jan-tec/tensile-tester/test/README

This directory is intended for PlatformIO Test Runner and project tests.

Unit Testing is a software testing method by which individual units of
source code, sets of one or more MCU program modules together with associated
control data, usage procedures, and operating procedures, are tested to
determine whether they are fit for use. Unit testing finds problems early
in the development cycle.

More information about PlatformIO Unit Testing:
- https://docs.platformio.org/en/latest/advanced/unit-testing/index.html

## House Unity notes

- Unity (as bundled with PlatformIO) has **no `TEST_ASSERT_NOT_EQUAL_STRING`**
  - use `TEST_ASSERT_TRUE(strcmp(a, b) != 0)` instead (found 2026-10-11, M6-T004).
- Exact-string pins are the house style for wire formats and message
  tables (`TEST_ASSERT_EQUAL_STRING`) - see `test_api_response.cpp` for
  the JSON envelope pins.
