jan-tec/tensile-tester/hardware/mainboard-atlas/Mainboard-ATLAS.kicad_pcb

## KiCad design hardware/mainboard-atlas/Mainboard-ATLAS.kicad_pcb (2026-10-11)

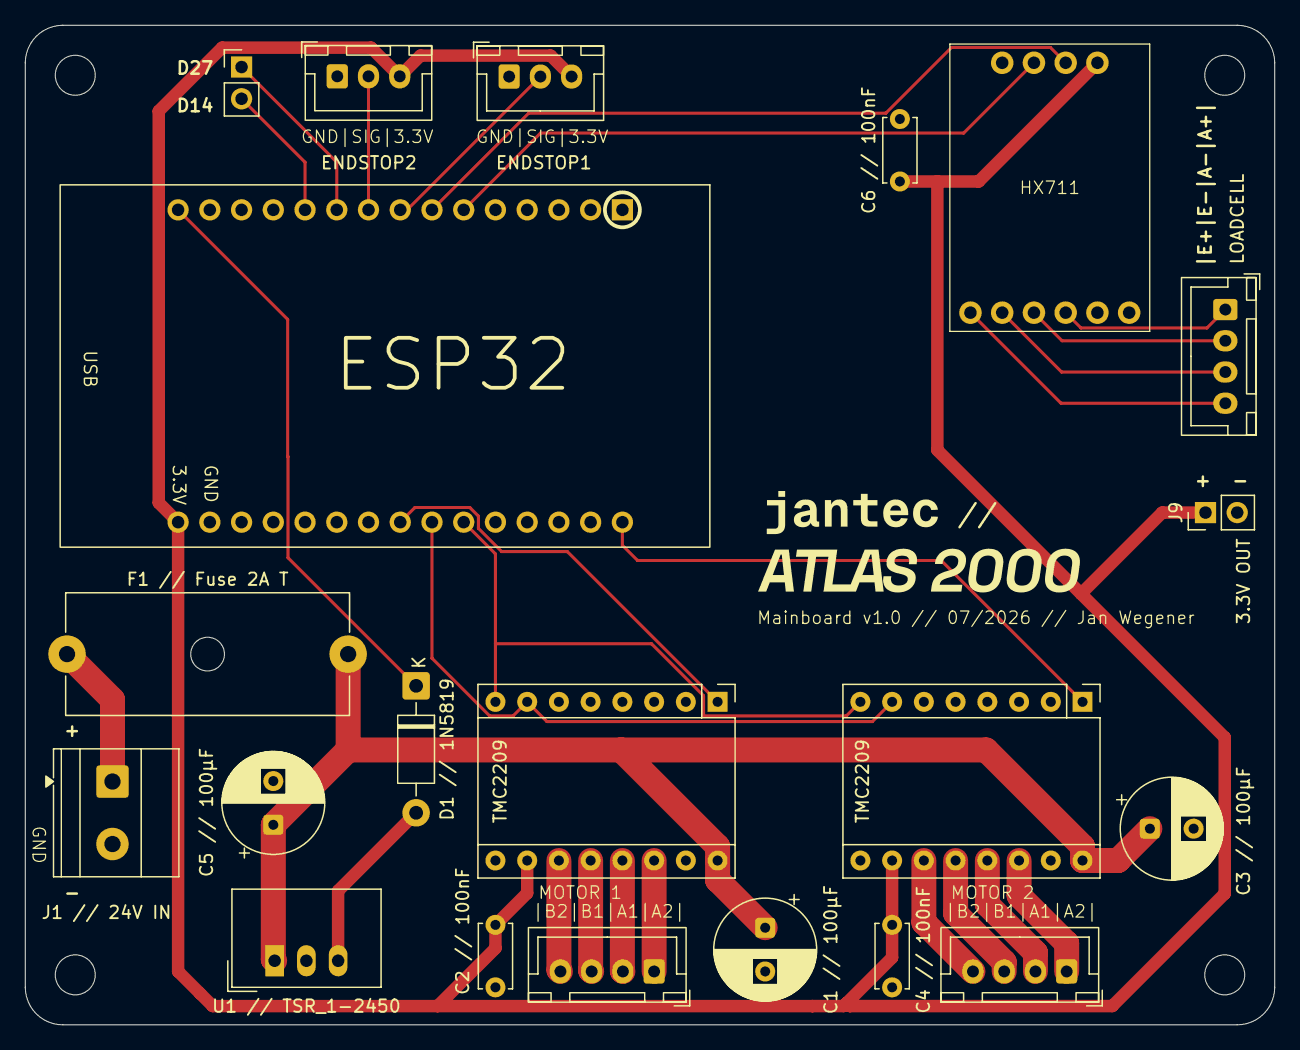
[picture p1: board Mainboard-ATLAS.kicad_pcb from above]

Board: 2 copper layers, 100.0 x 80.0 mm, 21 parts (0 on the bottom side), 28 nets.

Parts:
C1 // 100µF, C3 // 100µF, C5 // 100µF: 100µF/35V; CP_Radial_D8.0mm_P3.50mm
C2 // 100nF, C4 // 100nF, C6 // 100nF: 100nF; C_Disc_D5.0mm_W2.5mm_P5.00mm
D1 // 1N5819: 1N5819; D_DO-41_SOD81_P10.16mm_Horizontal
ENDSTOP1, ENDSTOP2: Conn_01x03_Pin; JST_XH_B3B-XH-A_1x03_P2.50mm_Vertical
ESP1: ESP32_2x15_P254_Row25
F1 // Fuse 2A T: Fuse 2A T; Fuseholder_Cylinder-5x20mm_Schurter_0031_8201_Horizontal_Op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
HX711: HX711-Breakout-6-4
J1: J1 // 24V IN; TerminalBlock_Phoenix_MKDS-1,5-2_1x02_P5.00mm_Horizontal
J2, J3: Conn_01x04; JST_XH_B4B-XH-A_1x04_P2.50mm_Vertical
J7: Conn_01x02; PinHeader_1x02_P2.54mm_Vertical
J9: 3.3V OUT; PinHeader_1x02_P2.54mm_Vertical
LOADCELL: Conn_01x04; JST_XH_B4B-XH-A_1x04_P2.50mm_Vertical
TMC2209, TMC2209#2: Pololu_Breakout-16_15.2x20.3mm
U1 // TSR_1-2450: TSR_1-2450; Converter_DCDC_TRACO_TSR-1_THT

Connections:
+3.3VA: C2 // 100nF.1, C4 // 100nF.1, C6 // 100nF.1, ENDSTOP1.3, ENDSTOP2.3, ESP1.30 (3.3V), HX711.10 (VCC), J9.1, TMC2209.15 (VDD), TMC2209#2.15 (VDD)
+5V_REG: D1 // 1N5819.2 (A), U1 // TSR_1-2450.3 (Vout)
+24V: C1 // 100µF.1, C3 // 100µF.1, C5 // 100µF.1, F1 // Fuse 2A T.2, TMC2209.9 (VM), TMC2209#2.9 (VM), U1 // TSR_1-2450.1 (Vin)
+24V_IN: F1 // Fuse 2A T.1, J1.1
D14: ESP1.11 (D14), J7.2
D27: ESP1.10 (D27), J7.1
DIR: ESP1.21 (D19), TMC2209.8 (DIR), TMC2209#2.8 (DIR)
EN1: ESP1.23 (D5), TMC2209.1 (EN)
EN2: ESP1.16 (D23), TMC2209#2.1 (EN)
ENDSTOP1: ENDSTOP1.2, ESP1.8 (D25)
ENDSTOP2: ENDSTOP2.2, ESP1.9 (D26)
GND: C1 // 100µF.2, C2 // 100nF.2, C3 // 100µF.2, C4 // 100nF.2, C5 // 100µF.2, C6 // 100nF.2, ENDSTOP1.1, ENDSTOP2.1, ESP1.29 (GND), HX711.7 (GND), J1.2, J9.2, TMC2209.10 (GND), TMC2209.16 (GND), TMC2209#2.10 (GND), TMC2209#2.16 (GND), U1 // TSR_1-2450.2 (GND)
HX_DOUT: ESP1.6 (D32), HX711.8 (DT)
HX_SCK: ESP1.7 (D33), HX711.9 (SCK)
M1_A1: J2.2, TMC2209.12 (A1)
M1_A2: J2.1, TMC2209.11 (A2)
M1_B1: J2.3, TMC2209.13 (B1)
M1_B2: J2.4, TMC2209.14 (B2)
M2_A1: J3.2, TMC2209#2.12 (A1)
M2_A2: J3.1, TMC2209#2.11 (A2)
M2_B1: J3.3, TMC2209#2.13 (B1)
M2_B2: J3.4, TMC2209#2.14 (B2)
unnamed: D1 // 1N5819.1 (K), ESP1.15 (Vin)
unnamed: HX711.4 (A+), LOADCELL.1
unnamed: HX711.3 (A-), LOADCELL.2
unnamed: HX711.1 (E+), LOADCELL.4
unnamed: HX711.2 (E-), LOADCELL.3
STEP: ESP1.22 (D18), TMC2209.7 (STEP), TMC2209#2.7 (STEP)
