jan-tec/tensile-tester/src/Commands.cpp

#include "Commands.h"

#include "Diagnostics.h"
#include "Settings.h"
#include "TestRunner.h"
#include "Text.h"

String Commands::helpText() {
  return String(msg(Msg::HelpCommandsPrefix)) + msg(Msg::HelpCommandsSuffix);
}

// M6 FR-002 (plan D2): one snapshot per reply/event - the envelope and
// event renderers consume this; never read members twice for one line.
ApiStateSnapshot Commands::stateSnapshot() {
  ApiStateSnapshot s{};
  s.posMm = motion_.positionMm();
  s.forceN = loadcell_.forceNewton();
  s.cellReady = loadcell_.isReady();
  s.calValid = loadcell_.calibrationValid();
  s.homed = testRunner_.homed();
  s.faultCode = diagnostics_.model().faultCode();
  s.cycleState = TestCycleModel::name(testRunner_.testState());
  return s;
}

ParseResult Commands::parseValueAfterCommand(const String &command,
                                             const char *prefix,
                                             float &value) const {
  // jane: parseCommandValue buffers 47-char numbers; the legacy String
  // version had no limit, but no realistic command (float has ~7
  // significant digits) can observe the difference.
  return parseCommandValue(command.c_str(), prefix, &value);
}

bool Commands::reportInvalidValue(String &response, ErrorCode &error) const {
  response = msg(Msg::InvalidValue);
  error = ErrorCode::InvalidValue;
  return false;
}

ParseResult Commands::parseIndexAfterCommand(const String &command,
                                             const char *prefix,
                                             uint32_t &index) const {
  return parseCommandIndex(command.c_str(), prefix, &index);
}

bool Commands::testConfigChangeAllowed(String &response,
                                       ErrorCode &error) const {
  if (diagnostics_.model().state() == DeviceState::Error) {
    response = msg(Msg::ConfigLockedInFault);
    // Same rule as the motion rejection: surface the fault itself.
    error = static_cast<ErrorCode>(diagnostics_.model().faultCode());
    return false;
  }
  if (testRunner_.active()) {
    response = msg(Msg::CycleBusy);
    error = ErrorCode::StateConflict;
    return false;
  }
  return true;
}

bool Commands::plainMoveAllowed(String &response, ErrorCode &error) const {
  if (testRunner_.active()) {
    response = msg(Msg::CycleBusy);
    error = ErrorCode::StateConflict;
    return false;
  }
  if (testRunner_.dumpInProgress()) {
    response = msg(Msg::DumpBusy);
    error = ErrorCode::StateConflict;
    return false;
  }
  return true;
}

bool Commands::applyTestConfigValue(float value, String &response,
                                    ErrorCode &error,
                                    float TestConfig::*field,
                                    const char *suffix) {
  if (value <= 0.0f) {
    response = msg(Msg::ValueMustBePositive);
    error = ErrorCode::InvalidValue;
    return false;
  }
  if (!testConfigChangeAllowed(response, error)) {
    return false;
  }
  TestConfig config = testRunner_.config();
  config.*field = value;
  testRunner_.applyConfig(config);
  settings_.saveTestConfig(testRunner_.config());
  // Reply with the EFFECTIVE value: clampTestConfig may have adjusted it
  // (FR-005) and the operator needs to see what is now in force.
  response = String(testRunner_.config().*field, 2) + suffix;
  return true;
}

void Commands::pollDump() {
  if (!testRunner_.dumpInProgress()) {
    return;
  }
  // D8/NFR: write only what the TX buffer can take in one go; the dump
  // resumes on the next tick, never blocking the loop task.
  if (static_cast<size_t>(Serial.availableForWrite()) < kCsvChunkBytes) {
    return;
  }
  char chunk[kCsvChunkBytes];
  size_t next = testRunner_.nextDumpIndex();
  const size_t from = next;
  const size_t written = formatCsvChunk(testRunner_.samples(), next, chunk,
                                        sizeof(chunk), &next);
  testRunner_.advanceDump(next);
  if (written > 0) {
    Serial.write(reinterpret_cast<const uint8_t *>(chunk), written);
  }
  // Documented caller stop rule (TestData.h): 0 bytes = complete (or a
  // buffer too small for one line - impossible at 128 B), and a chunk
  // that wrote bytes WITHOUT advancing is the END-marker-only final
  // chunk (the empty-buffer document) - both finish the dump.
  if (written == 0 || next == from) {
    testRunner_.endDump(next);
  }
}

bool Commands::execute(String command, String &response, ErrorCode &error,
                       ApiReplyMeta &meta) {
  command.trim();
  error = ErrorCode::None;
  meta = ApiReplyMeta{};  // kind defaults to Reply
  if (command.isEmpty()) {
    response = msg(Msg::EmptyCommand);
    error = ErrorCode::EmptyCommand;
    return false;
  }

  // FR-009: in the Error state the driver stays off; motion commands
  // are rejected with the fault code + message. Recovery by reset/reboot.
  const DeviceModel &model = diagnostics_.model();
  if (model.state() == DeviceState::Error &&
      isMotionCommand(command.c_str())) {
    // M2-T004 (FR-007): the fault code carries its localized detail
    // message (e.g. POWER_LOW -> "Supply voltage too low"). The prefix
    // rows already end in "0x" - bench-found double prefix fixed here:
    // only the padded hex digits are appended (code 0x0501, #97 grammar).
    char buffer[160];
    snprintf(buffer, sizeof(buffer), "%s%04X%s %s", msg(Msg::FaultStatePrefix),
             model.faultCode(), msg(Msg::FaultStateSuffix),
             msg(msgForFault(static_cast<ErrorCode>(model.faultCode()))));
    response = String(buffer);
    // The rejection IS the fault: the envelope surfaces the 0x01xx..0x05xx
    // code itself (ApiResponse contract: fault codes may ride error.code).
    error = static_cast<ErrorCode>(model.faultCode());
    return false;
  }

  // M2-T003 (FR-003): locale switch, usable in every state (not motion).
  Locale locale = textLocale();
  const ParseResult langResult =
      parseLocaleAfterCommand(command.c_str(), "lang", &locale);
  if (langResult == ParseResult::InvalidValue) {
    return reportInvalidValue(response, error);
  }
  if (langResult == ParseResult::Ok) {
    setTextLocale(locale);
    settings_.saveLocale(locale);
    response = String(msg(Msg::LangSet)) + localeName(locale);
    return true;
  }

  const Command named = commandFromName(command.c_str());

  if (named == Command::Enable) {
    motion_.enable();
    response = msg(Msg::DriversEnabled);
    return true;
  }

  if (named == Command::Disable) {
    motion_.disable();
    response = msg(Msg::DriversDisabled);
    return true;
  }

  if (named == Command::Zero) {
    motion_.zero();
    response = msg(Msg::OriginZeroed);
    return true;
  }

  if (named == Command::Tare) {
    loadcell_.tare();
    response = loadcell_.isReady() ? msg(Msg::LoadCellTared)
                                   : msg(Msg::Hx711NotReady);
    if (!loadcell_.isReady()) {
      // jane: lossy mapping (plan D8 risk note) - the HX711-unavailable
      // family shares NotCalibrated until a consumer needs the split.
      error = ErrorCode::NotCalibrated;
      return false;
    }
    return true;
  }

  if (named == Command::CalZero) {
    if (!loadcell_.captureZeroPoint()) {
      response = msg(Msg::Hx711NotReady);
      error = ErrorCode::NotCalibrated;  // jane: lossy, see Tare
      return false;
    }
    response = msg(Msg::CalZeroCaptured);
    return true;
  }

  float value = 0.0f;

  const ParseResult calApplyResult =
      parseValueAfterCommand(command, "cal_apply", value);
  if (calApplyResult == ParseResult::InvalidValue) {
    return reportInvalidValue(response, error);
  }
  if (calApplyResult == ParseResult::Ok) {
    switch (loadcell_.calibrateWithMass(value)) {
      case LoadCell::CalError::NotReady:
        response = msg(Msg::Hx711NotReady);
        error = ErrorCode::NotCalibrated;  // jane: lossy, see Tare
        return false;
      case LoadCell::CalError::ZeroNotCaptured:
        response = msg(Msg::CalStep1First);
        // Wizard-sequence conflict: step 2 before step 1.
        error = ErrorCode::StateConflict;
        return false;
      case LoadCell::CalError::InvalidMass:
        response = msg(Msg::CalWeightMustBePositive);
        error = ErrorCode::InvalidValue;
        return false;
      case LoadCell::CalError::ReadFailed:
        response = msg(Msg::CalValueUnreadable);
        error = ErrorCode::NotCalibrated;  // jane: lossy, see Tare
        return false;
      case LoadCell::CalError::ZeroFactor:
        response = msg(Msg::CalFailedZeroFactor);
        error = ErrorCode::NotCalibrated;
        return false;
      case LoadCell::CalError::NegativeFactor:
        response = msg(Msg::CalFailedNegativeFactor);
        error = ErrorCode::NotCalibrated;
        return false;
      case LoadCell::CalError::None:
        break;
    }
    calAppliedEvent_ = true;  // M8-T003: CalApplied LED overlay
    response = String(msg(Msg::CalSaved)) +
               String(loadcell_.calibrationFactor(), 6);
    return true;
  }

  if (named == Command::Force) {
    if (loadcell_.isReady()) {
      response = String(msg(Msg::ForceCurrent)) +
                 String(loadcell_.forceNewton(), 2) + msg(Msg::NewtonSuffix);
    } else {
      response = msg(Msg::ForceUnavailable);
    }
    return true;
  }

  if (named == Command::Stop) {
    // M3 T012: a running cycle/homing aborts through the runner first
    // (forceStop semantics); a plain move keeps its decel `stop`.
    if (testRunner_.abort()) {
      response = msg(Msg::TestAbortedNote);
    } else {
      motion_.stop();
      response = msg(Msg::StopRequested);
    }
    return true;
  }

  if (named == Command::Home || named == Command::HomeTop) {
    // D11: exclusive; the D15 Error-state rejection already ran above.
    // #158: also exclusive with an in-flight plain move - the homing
    // FSM expects to own the stepper from its first phase.
    if (testRunner_.active() || motion_.isRunning()) {
      response = msg(Msg::CycleBusy);
      error = ErrorCode::StateConflict;
      return false;
    }
    if (testRunner_.dumpInProgress()) {
      // A started test would clear the sample buffer mid-dump (and a
      // homing report line would land inside the CSV stream).
      response = msg(Msg::DumpBusy);
      error = ErrorCode::StateConflict;
      return false;
    }
    const bool topOnly = named == Command::HomeTop;
    if (!testRunner_.startHome(topOnly)) {
      // Homing FSM latched Fault (device Error) - unreachable through the
      // Error gate above, kept as a defensive no-crash path.
      response = msg(Msg::CycleBusy);
      error = ErrorCode::StateConflict;
      return false;
    }
    response = msg(topOnly ? Msg::HomeTopStarted : Msg::HomeStarted);
    return true;
  }

  if (named == Command::Test) {
    // #158: like home - exclusive with an in-flight plain move.
    if (testRunner_.active() || motion_.isRunning()) {
      response = msg(Msg::CycleBusy);
      error = ErrorCode::StateConflict;
      return false;
    }
    if (testRunner_.dumpInProgress()) {
      // startTest() clears the buffer - mid-dump that destroys the very
      // data being streamed (US2).
      response = msg(Msg::DumpBusy);
      error = ErrorCode::StateConflict;
      return false;
    }
    if (!testRunner_.startTest()) {
      response = msg(Msg::CycleBusy);
      error = ErrorCode::StateConflict;
      return false;
    }
    response = msg(Msg::TestStarted);
    return true;
  }

  if (named == Command::Pos) {
    // M6-T006 (D2/D6): steps ride the data fragment; travel/force live
    // in the state object every envelope carries. response stays the
    // ack line so the web path keeps its byte-identical HTTP body
    // (FR-006).
    meta.kind = ApiDataKind::Pos;
    meta.steps = motion_.steps();
    response = msg(Msg::PositionPrinted);
    return true;
  }

  if (command == "help") {
    // M6-T006 (FR-003/D6): help is a real command now - the serial
    // envelope carries the array (formatApiHelpData via the surface);
    // response keeps the localized prose for the web HTTP path.
    meta.kind = ApiDataKind::Help;
    response = helpText();
    return true;
  }

  const ParseResult rpmResult = parseValueAfterCommand(command, "rpm", value);
  if (rpmResult == ParseResult::InvalidValue) {
    return reportInvalidValue(response, error);
  }
  if (rpmResult == ParseResult::Ok) {
    if (value <= 0.0f) {
      response = msg(Msg::RpmMustBePositive);
      error = ErrorCode::InvalidValue;
      return false;
    }

    motion_.setOutputRpm(value);
    response = String(msg(Msg::RpmSet)) + String(motion_.outputRpm(), 2) +
               msg(Msg::RpmSuffix);
    return true;
  }

  const ParseResult accResult = parseValueAfterCommand(command, "acc", value);
  if (accResult == ParseResult::InvalidValue) {
    return reportInvalidValue(response, error);
  }
  if (accResult == ParseResult::Ok) {
    if (value <= 0.0f) {
      response = msg(Msg::AccelMustBePositive);
      error = ErrorCode::InvalidValue;
      return false;
    }

    motion_.setAccelRpmPerS(value);
    response = String(msg(Msg::AccelSet)) + String(motion_.accelRpmPerS(), 2) +
               msg(Msg::AccelSuffix);
    return true;
  }

  const ParseResult feedResult =
      parseValueAfterCommand(command, "feed", value);
  if (feedResult == ParseResult::InvalidValue) {
    return reportInvalidValue(response, error);
  }
  if (feedResult == ParseResult::Ok) {
    if (value <= 0.0f) {
      response = msg(Msg::FeedMustBePositive);
      error = ErrorCode::InvalidValue;
      return false;
    }

    const float clampedFeed = clampFeedMmPerMin(value);
    motion_.setOutputRpm(feedMmPerMinToRpm(clampedFeed));
    response = String(msg(Msg::FeedSet)) + String(clampedFeed, 2) +
               msg(Msg::MillimetrePerMinuteSuffix);
    return true;
  }

  if (named == Command::JogUp) {
    if (!plainMoveAllowed(response, error)) {
      return false;
    }
    motion_.startMoveToSteps(
        static_cast<long>(motion_.steps() + spindleMmToSteps(kJogTravelMm)));
    response = msg(Msg::JogUpStarted);
    return true;
  }

  if (named == Command::JogDown) {
    if (!plainMoveAllowed(response, error)) {
      return false;
    }
    motion_.startMoveToSteps(
        static_cast<long>(motion_.steps() - spindleMmToSteps(kJogTravelMm)));
    response = msg(Msg::JogDownStarted);
    return true;
  }

  const ParseResult moveResult = parseValueAfterCommand(command, "move", value);
  if (moveResult == ParseResult::InvalidValue) {
    return reportInvalidValue(response, error);
  }
  if (moveResult == ParseResult::Ok) {
    if (!plainMoveAllowed(response, error)) {
      return false;
    }
    motion_.startMoveToSteps(
        static_cast<long>(motion_.steps() + spindleMmToSteps(value)));
    response = String(msg(Msg::RelativeMoveStarted)) + String(value, 3) +
               msg(Msg::MillimetreSuffix);
    return true;
  }

  const ParseResult turnResult = parseValueAfterCommand(command, "turn", value);
  if (turnResult == ParseResult::InvalidValue) {
    return reportInvalidValue(response, error);
  }
  if (turnResult == ParseResult::Ok) {
    if (!plainMoveAllowed(response, error)) {
      return false;
    }
    motion_.startMoveToSteps(
        static_cast<long>(motion_.steps() + outputTurnsToSteps(value)));
    response = String(msg(Msg::RelativeMoveStarted)) + String(value, 3) +
               msg(Msg::RevolutionsSuffix);
    return true;
  }

  // M4 FR-001 (T006): constant-force hold.
  {
    float holdSetpoint = 0.0f;
    float holdMinutes = 0.0f;
    const ParseResult choldResult = parseCholdCommand(command.c_str(),
                                                      &holdSetpoint,
                                                      &holdMinutes);
    if (choldResult == ParseResult::InvalidValue) {
      return reportInvalidValue(response, error);
    }
    if (choldResult == ParseResult::Ok) {
      if (testRunner_.active()) {
        response = msg(Msg::CycleBusy);
        error = ErrorCode::StateConflict;
        return false;
      }
      if (testRunner_.dumpInProgress()) {
        response = msg(Msg::DumpBusy);
        error = ErrorCode::StateConflict;
        return false;
      }
      if (!testRunner_.startHold(holdSetpoint, holdMinutes)) {
        // Zero/non-finite setpoint (busy/fault cases are covered above).
        response = msg(Msg::HoldSetpointRequired);
        error = ErrorCode::InvalidValue;
        return false;
      }
      // Echo the EFFECTIVE setpoint: the D7 envelope + the operator's
      // per-sample ceiling (choldmax) may both have adjusted it (#220).
      const float setpoint =
          effectiveHoldSetpointN(holdSetpoint, testRunner_.config());
      response = String(msg(Msg::HoldStarted)) + String(setpoint, 2);
      if (holdMinutes > 0.0f) {
        response += String(msg(Msg::HoldForMinutes)) +
                    String(holdMinutes, 1) + msg(Msg::MinutesSuffix);
      } else {
        response += msg(Msg::HoldUntilStop);
      }
      return true;
    }
  }

  // M4 FR-001: hold config knobs (persisted, clamped; TestConfig fields).
  const ParseResult holdTolResult =
      parseValueAfterCommand(command, "choltol", value);
  if (holdTolResult == ParseResult::InvalidValue) {
    return reportInvalidValue(response, error);
  }
  if (holdTolResult == ParseResult::Ok) {
    return applyTestConfigValue(value, response, error,
                                &TestConfig::holdTolerancePct,
                                msg(Msg::PercentSuffix));
  }

  const ParseResult holdClearResult =
      parseValueAfterCommand(command, "choldclear", value);
  if (holdClearResult == ParseResult::InvalidValue) {
    return reportInvalidValue(response, error);
  }
  if (holdClearResult == ParseResult::Ok) {
    return applyTestConfigValue(value, response, error,
                                &TestConfig::holdClearanceMm,
                                msg(Msg::MillimetreSuffix));
  }

  // #220: per-sample hold ceiling (persisted, clamped [1, 4000] N).
  const ParseResult holdMaxResult =
      parseValueAfterCommand(command, "choldmax", value);
  if (holdMaxResult == ParseResult::InvalidValue) {
    return reportInvalidValue(response, error);
  }
  if (holdMaxResult == ParseResult::Ok) {
    return applyTestConfigValue(value, response, error,
                                &TestConfig::holdMaxN,
                                msg(Msg::NewtonSuffix));
  }

  // M3 T012: test config knobs (persisted, clamped; FR-005).
  const ParseResult testSpeedResult =
      parseValueAfterCommand(command, "testspeed", value);
  if (testSpeedResult == ParseResult::InvalidValue) {
    return reportInvalidValue(response, error);
  }
  if (testSpeedResult == ParseResult::Ok) {
    return applyTestConfigValue(value, response, error,
                                &TestConfig::testSpeedMmPerMin,
                                msg(Msg::MillimetrePerMinuteSuffix));
  }

  const ParseResult testArmResult =
      parseValueAfterCommand(command, "testarm", value);
  if (testArmResult == ParseResult::InvalidValue) {
    return reportInvalidValue(response, error);
  }
  if (testArmResult == ParseResult::Ok) {
    return applyTestConfigValue(value, response, error,
                                &TestConfig::armForceN,
                                msg(Msg::NewtonSuffix));
  }

  const ParseResult testDropResult =
      parseValueAfterCommand(command, "testdrop", value);
  if (testDropResult == ParseResult::InvalidValue) {
    return reportInvalidValue(response, error);
  }
  if (testDropResult == ParseResult::Ok) {
    return applyTestConfigValue(value, response, error,
                                &TestConfig::dropPercent,
                                msg(Msg::PercentSuffix));
  }

  // #157: the homing reach knobs. Seek speed 0 = follow the test speed;
  // timeout in seconds (clamp [1, 300] s via clampTestConfig) - at the
  // spec default 30 s x 12 mm/min the seek only covers ~6 mm, which the
  // bench showed is far short of a mid-travel start.
  const ParseResult homeSeekResult =
      parseValueAfterCommand(command, "homeseek", value);
  if (homeSeekResult == ParseResult::InvalidValue) {
    return reportInvalidValue(response, error);
  }
  if (homeSeekResult == ParseResult::Ok) {
    if (value < 0.0f) {
      response = msg(Msg::ValueMustBePositive);
      error = ErrorCode::InvalidValue;
      return false;
    }
    if (!testConfigChangeAllowed(response, error)) {
      return false;
    }
    TestConfig config = testRunner_.config();
    config.homingSeekMmPerMin = value;  // 0 = follow the test speed
    testRunner_.applyConfig(config);
    settings_.saveTestConfig(testRunner_.config());
    if (testRunner_.config().homingSeekMmPerMin == 0.0f) {
      response = msg(Msg::HomeSeekFollows);
    } else {
      response =
          String(testRunner_.config().homingSeekMmPerMin, 2) +
          msg(Msg::MillimetrePerMinuteSuffix);
    }
    return true;
  }

  const ParseResult homeTimeoutResult =
      parseValueAfterCommand(command, "hometimeout", value);
  if (homeTimeoutResult == ParseResult::InvalidValue) {
    return reportInvalidValue(response, error);
  }
  if (homeTimeoutResult == ParseResult::Ok) {
    if (value <= 0.0f || value > 300.0f) {
      response = msg(Msg::ValueMustBePositive);
      error = ErrorCode::InvalidValue;
      return false;
    }
    if (!testConfigChangeAllowed(response, error)) {
      return false;
    }
    TestConfig config = testRunner_.config();
    config.homingTimeoutMs =
        static_cast<uint32_t>(value * 1000.0f);
    testRunner_.applyConfig(config);
    settings_.saveTestConfig(testRunner_.config());
    response = String(
                   testRunner_.config().homingTimeoutMs / 1000.0f, 0) +
               msg(Msg::SecondsSuffix);
    return true;
  }

  // `data [from-index]`: CSV dump (TC-005 resume grammar). Bare `data`
  // dumps from 0 (NotACommand from the index parser means no token).
  uint32_t dataIndex = 0;
  const ParseResult dataIndexResult =
      parseIndexAfterCommand(command, "data", dataIndex);
  if (dataIndexResult == ParseResult::InvalidValue) {
    return reportInvalidValue(response, error);
  }
  if (dataIndexResult == ParseResult::Ok) {
    if (testRunner_.active()) {
      response = msg(Msg::DumpBlockedRunning);
      error = ErrorCode::StateConflict;
      return false;
    }
    if (testRunner_.dumpInProgress()) {
      response = msg(Msg::DumpBusy);
      error = ErrorCode::StateConflict;
      return false;
    }
    testRunner_.beginDump(dataIndex);
    response = msg(Msg::DumpStarted);  // the CSV itself streams from
                                       // pollDump() in the loop task
    return true;
  }
  if (command == "data") {
    if (testRunner_.active()) {
      response = msg(Msg::DumpBlockedRunning);
      error = ErrorCode::StateConflict;
      return false;
    }
    if (testRunner_.dumpInProgress()) {
      response = msg(Msg::DumpBusy);
      error = ErrorCode::StateConflict;
      return false;
    }
    testRunner_.beginDump(static_cast<size_t>(0));
    response = msg(Msg::DumpStarted);
    return true;
  }

  if (command == "testdata") {
    // FR-005: machine-readable status via the pure formatter (stable
    // key=value grammar, locale-neutral numbers).
    char status[96];
    formatTestDataStatus(testRunner_.samples(), testRunner_.peakForceN(),
                         testRunner_.peakIndex(), status, sizeof(status));
    response = String(msg(Msg::TestdataPrefix)) + status;
    return true;
  }

  if (command == "ends") {
    // jane: bench debug telemetry (T014 homing diagnosis), deliberately
    // raw English like the FR-007 CHECK grammar - not a Msg row (it is
    // machine-facing debug output, never localized).
    const HomePhase phase = testRunner_.homing().phase();
    const char *phaseName = "?";
    switch (phase) {
      case HomePhase::Idle: phaseName = "Idle"; break;
      case HomePhase::BackOff: phaseName = "BackOff"; break;
      case HomePhase::SeekDown: phaseName = "SeekDown"; break;
      case HomePhase::FinalSeek: phaseName = "FinalSeek"; break;
      case HomePhase::SeekUp: phaseName = "SeekUp"; break;
      case HomePhase::BackOffDown: phaseName = "BackOffDown"; break;
      case HomePhase::Done: phaseName = "Done"; break;
      case HomePhase::Fault: phaseName = "Fault"; break;
    }
    char tel[96];
    // M4: HOP = hold phase (permanent bench telemetry - the temp-hook
    // lesson: hold state MUST be observable; T007 also consumes it).
    const char *holdName = "?";
    switch (testRunner_.holdPhase()) {
      case HoldController::Phase::Idle: holdName = "Idle"; break;
      case HoldController::Phase::Homing: holdName = "Homing"; break;
      case HoldController::Phase::Approach: holdName = "Approach"; break;
      case HoldController::Phase::Holding: holdName = "Holding"; break;
      case HoldController::Phase::Done: holdName = "Done"; break;
      case HoldController::Phase::Limit: holdName = "Limit"; break;
      case HoldController::Phase::Lost: holdName = "Lost"; break;
      case HoldController::Phase::Aborted: holdName = "Aborted"; break;
    }
    snprintf(tel, sizeof(tel), "E1:%d E2:%d HP:%s HF:%d HS:%s HOP:%s",
             testRunner_.endstopBottom() ? 1 : 0,
             testRunner_.endstopTop() ? 1 : 0, phaseName,
             static_cast<int>(testRunner_.homing().fault()),
             TestCycleModel::name(testRunner_.testState()), holdName);
    response = tel;
    return true;
  }

  response = msg(Msg::UnknownCommand);
  error = ErrorCode::UnknownCommand;
  return false;
}
