jan-tec/tensile-tester/src/Commands.h

// Command policy (M0-T006; M3-T012: test-cycle command surface).
//
// Owns the executeCommand() policy that previously lived inline in
// main.cpp: dispatch, validation, German response text, and the
// available-commands help list. Both entry points (serial CLI and Web
// API) call execute().
//
// Name matching uses the T002 parser (FirmwareCore::commandFromName);
// value parsing uses FirmwareCore::parseCommandValue via a String
// adapter. The quirk tracked in #41 (case-sensitive names) is preserved;
// #42 (word boundary) and #43 (garbage value -> 0.0 / truncated token)
// are fixed in their own PRs per the No-Quirk Policy.
//
// M3 (T012): home/home top/test route into TestRunner (D11 exclusivity,
// D15 Error rules); `stop` routes to the runner first; testspeed/
// testarm/testdrop persist through Settings; `data` streams the CSV in
// loop-tick chunks (D8) with the D14 status-line suppression riding on
// TestRunner::dumpInProgress().
#pragma once

#include <Arduino.h>
#include <ApiResponse.h>
#include <FirmwareCore.h>

#include "ErrorCode.h"
#include "LoadCell.h"
#include "Motion.h"

class Diagnostics;
class Settings;
class TestRunner;

// M6-T006 (plan D2/D6, #182): what the surface renders as the envelope's
// data fragment. The POLICY picks the kind, the SURFACE renders it -
// SerialCli maps Reply -> formatApiReplyData(response), Pos ->
// {"steps":N} (the rest of the position lives in the state object),
// Help -> formatApiHelpData (the documented >256 B exception).
enum class ApiDataKind { Reply, Pos, Help };

// M6 out-struct (T005 introduced PosData; T006 slims it to what the
// envelope needs - position text rendering is gone with the prose).
struct ApiReplyMeta {
  ApiDataKind kind = ApiDataKind::Reply;  // success data shape
  long steps = 0;                         // ApiDataKind::Pos
};

class Commands {
 public:
  Commands(Settings &settings, Motion &motion, LoadCell &loadcell,
           Diagnostics &diagnostics, TestRunner &testRunner)
      : settings_(settings),
        motion_(motion),
        loadcell_(loadcell),
        diagnostics_(diagnostics),
        testRunner_(testRunner) {}

  // Runs one command (trimmed or untrimmed) and fills response with the
  // localized status text (M2: all replies resolve through Text's msg();
  // the locale is switched with `lang <en|de>`). Returns true on success.
  // The Web API maps false to HTTP 400.
  //
  // M6-T005 (plan D1, #181): error receives the stable machine code for
  // every failure return (ErrorCode::None on success; a fault-code
  // rejection surfaces the 0x01xx..0x05xx fault). The serial path
  // renders it into the JSON envelope; the Web path ignores it - its
  // contract is the HTTP body alone (FR-006 byte-identical).
  // M6-T006: meta picks the success data fragment kind (D2/D6).
  bool execute(String command, String &response, ErrorCode &error,
               ApiReplyMeta &meta);

  // M6 FR-002 (plan D2): single state snapshot for the serial envelope;
  // every reply/event renders exactly one of these (one snapshot per
  // line, never a mid-command tear).
  ApiStateSnapshot stateSnapshot();

  // CSV dump pump (M3 D8): call from App::loop(); writes at most one
  // kCsvChunkBytes chunk per tick, only when the serial TX buffer can
  // take it whole. No-op unless a `data` command started a dump.
  void pollDump();

  // M8-T003: read-and-clear flag set by a successful cal_apply - App
  // turns it into the CalApplied LED overlay (Idle window, FR-005).
  bool consumeCalAppliedEvent() {
    const bool event = calAppliedEvent_;
    calAppliedEvent_ = false;
    return event;
  }

  // Help line (M2-T003): the localized prose list - the reply text of
  // the `help` command (web HTTP path) and the array's human twin; the
  // serial envelope carries formatApiHelpData instead (D6).
  static String helpText();

  // Jog travel for "jog up" / "jog down" (full spindle stroke); the jog
  // commands target current position +/- this distance.
  static constexpr float kJogTravelMm = 1000.0f;

  // One CSV chunk per loop tick, max (D8; NFR: the dump never blocks the
  // motor task). 128 B fits the default UART TX buffer in one write.
  static constexpr size_t kCsvChunkBytes = 128;

 private:
  // String adapter around the T002 parser (FirmwareCore::parseCommandValue).
  ParseResult parseValueAfterCommand(const String &command, const char *prefix,
                                     float &value) const;

  // String adapter around parseCommandIndex (`data <from>`).
  ParseResult parseIndexAfterCommand(const String &command, const char *prefix,
                                     uint32_t &index) const;

  // Shared response for ParseResult::InvalidValue (NQP #43): the token was
  // present but not a number, distinct from the per-command "> 0" errors.
  bool reportInvalidValue(String &response, ErrorCode &error) const;

  // Applies one test-config field change: rejects while a run is active
  // (applyConfig resets the homing FSM), clamps through the runner,
  // persists, replies with the EFFECTIVE (clamped) value + suffix.
  bool applyTestConfigValue(float value, String &response, ErrorCode &error,
                            float TestConfig::*field, const char *suffix);

  // Shared gate for config changes: locked in fault state (applyConfig
  // resets the homing FSM - unlatching its Fault behind the device
  // Error gate would blur FR-009's recovery rule) and rejected while a
  // run is active (D11). True when the change may proceed.
  bool testConfigChangeAllowed(String &response, ErrorCode &error) const;

  // #158 (M3 FR-009): plain moves (move/jog/turn) are exclusive with
  // runner motion - a move during a live homing hijacks the stepper
  // target while the FSM waits for the switch - and with a serial CSV
  // dump (the reply would land inside the stream). True when the move
  // may proceed.
  bool plainMoveAllowed(String &response, ErrorCode &error) const;

  Settings &settings_;
  Motion &motion_;
  LoadCell &loadcell_;
  Diagnostics &diagnostics_;
  TestRunner &testRunner_;

  bool calAppliedEvent_ = false;  // M8-T003 (consumed by App's LED block)
};
