jan-tec/tensile-tester/test/test_api_response.cpp

// Unit tests for the M6 serial API envelope (host side, env:native).
// Run: pio test -e native
//
// #178 (M6-T002), spec FR-001/FR-002, TC-001/TC-002: the response line
// is a wire contract - fixed key order, locale-neutral decimals, ASCII
// escaping, <=256 B. Pinned as exact strings so any formatter drift is
// a host test failure, not a bench surprise.
#include <unity.h>

#include <cstring>

#include <ApiResponse.h>

static ApiStateSnapshot benchSnapshot() {
  // Post-B1 reality 2026-10-11: homed, calibrated, broken sample gone,
  // Idle, no fault (numbers from the #48 calibration session).
  ApiStateSnapshot s{};
  s.posMm = 11.666f;
  s.forceN = 155.71f;
  s.cellReady = true;
  s.calValid = true;
  s.homed = true;
  s.faultCode = 0;
  s.cycleState = "Idle";
  return s;
}

// TC-001: exact success envelope, fixed key order ok -> data -> state.
void test_success_envelope_exact(void) {
  char out[256];
  const int n = formatApiSuccess(benchSnapshot(), "{}", out, sizeof(out));
  TEST_ASSERT_EQUAL_STRING(
      "{\"ok\":true,\"data\":{},\"state\":{\"posMm\":11.666,\"forceN\":155.71,"
      "\"calValid\":true,\"cycleState\":\"Idle\",\"faultCode\":0,"
      "\"homed\":true}}",
      out);
  TEST_ASSERT_EQUAL_INT(static_cast<int>(strlen(out)), n);
}

// TC-001: error envelope - decimal code, escaped message, state last.
void test_error_envelope_exact(void) {
  char out[256];
  const int n =
      formatApiError(benchSnapshot(), 0x0601, "unknown command", out,
                     sizeof(out));
  TEST_ASSERT_EQUAL_STRING(
      "{\"ok\":false,\"error\":{\"code\":1537,"
      "\"message\":\"unknown command\"},\"state\":{\"posMm\":11.666,"
      "\"forceN\":155.71,\"calValid\":true,\"cycleState\":\"Idle\","
      "\"faultCode\":0,\"homed\":true}}",
      out);
  TEST_ASSERT_EQUAL_INT(static_cast<int>(strlen(out)), n);
}

// TC-002: unhomed + cell not ready -> null members (the n/a prose of the
// old multi-line status becomes JSON null, FR-002).
void test_state_null_members_when_unknown(void) {
  char out[256];
  ApiStateSnapshot s = benchSnapshot();
  s.homed = false;
  s.cellReady = false;
  s.calValid = false;
  s.cycleState = "Idle";
  formatApiSuccess(s, "null", out, sizeof(out));
  TEST_ASSERT_EQUAL_STRING(
      "{\"ok\":true,\"data\":null,\"state\":{\"posMm\":null,\"forceN\":null,"
      "\"calValid\":false,\"cycleState\":\"Idle\",\"faultCode\":0,"
      "\"homed\":false}}",
      out);
}

// TC-002: fault + cycle states render without special casing.
void test_state_fault_and_cycle(void) {
  char out[256];
  ApiStateSnapshot s = benchSnapshot();
  s.faultCode = 0x0501;
  s.cycleState = "Pulling";
  formatApiStateJson(s, out, sizeof(out));
  TEST_ASSERT_EQUAL_STRING(
      "{\"posMm\":11.666,\"forceN\":155.71,\"calValid\":true,"
      "\"cycleState\":\"Pulling\",\"faultCode\":1281,\"homed\":true}",
      out);
}

// TC-001: escaping - quote, backslash, newline, control char.
void test_error_message_escaping(void) {
  char out[256];
  formatApiError(benchSnapshot(), 0x0602, "bad \"x\\y\"\n\t\x01", out,
                 sizeof(out));
  TEST_ASSERT_NOT_NULL(strstr(out, "\\\"x\\\\y\\\"\\n\\t\\u0001"));
}

// D3: async lines carry a top-level event key, state second.
void test_event_line_exact(void) {
  char out[256];
  formatApiEvent("status", benchSnapshot(), out, sizeof(out));
  TEST_ASSERT_EQUAL_STRING(
      "{\"event\":\"status\",\"state\":{\"posMm\":11.666,\"forceN\":155.71,"
      "\"calValid\":true,\"cycleState\":\"Idle\",\"faultCode\":0,"
      "\"homed\":true}}",
      out);
}

// M6-T006 (#182): the reply data fragment for text replies - a JSON
// object wrapping the (escaped) localized response text.
void test_reply_data_exact(void) {
  char out[64];
  const int n = formatApiReplyData("", out, sizeof(out));
  TEST_ASSERT_EQUAL_STRING("{\"reply\":\"\"}", out);
  TEST_ASSERT_EQUAL_INT(static_cast<int>(strlen(out)), n);
  formatApiReplyData("Drivers enabled.", out, sizeof(out));
  TEST_ASSERT_EQUAL_STRING("{\"reply\":\"Drivers enabled.\"}", out);
}

void test_reply_data_escapes(void) {
  char out[64];
  formatApiReplyData("a\"b\\c\nd\te", out, sizeof(out));
  TEST_ASSERT_EQUAL_STRING("{\"reply\":\"a\\\"b\\\\c\\nd\\te\"}", out);
}

void test_reply_data_truncation_signalled(void) {
  char out[12];
  const int n = formatApiReplyData("0123456789ABCDEF", out, sizeof(out));
  TEST_ASSERT_TRUE(n >= static_cast<int>(sizeof(out)));
  TEST_ASSERT_EQUAL_CHAR('\0', out[sizeof(out) - 1]);
}

// D3: the web-command echo event (emitter #2) - command, outcome and
// the localized response ride one JSON line; state last as everywhere.
void test_web_command_event_exact(void) {
  char out[256];
  const int n = formatApiWebCommandEvent("move 5", true, "ok", benchSnapshot(),
                                         out, sizeof(out));
  TEST_ASSERT_EQUAL_STRING(
      "{\"event\":\"web_command\",\"command\":\"move 5\",\"ok\":true,"
      "\"message\":\"ok\",\"state\":{\"posMm\":11.666,\"forceN\":155.71,"
      "\"calValid\":true,\"cycleState\":\"Idle\",\"faultCode\":0,"
      "\"homed\":true}}",
      out);
  TEST_ASSERT_EQUAL_INT(static_cast<int>(strlen(out)), n);
}

void test_web_command_event_escapes_and_false(void) {
  char out[256];
  formatApiWebCommandEvent("say \"hi\"", false, "bad \"x\"\n", benchSnapshot(),
                           out, sizeof(out));
  TEST_ASSERT_NOT_NULL(strstr(out, "\"command\":\"say \\\"hi\\\"\""));
  TEST_ASSERT_NOT_NULL(strstr(out, "\"ok\":false"));
  TEST_ASSERT_NOT_NULL(strstr(out, "\"message\":\"bad \\\"x\\\"\\n\""));
}

void test_web_command_event_truncation_signalled(void) {
  char out[16];
  const int n = formatApiWebCommandEvent("c", true, "m", benchSnapshot(), out,
                                         sizeof(out));
  TEST_ASSERT_TRUE(n >= static_cast<int>(sizeof(out)));
  TEST_ASSERT_EQUAL_CHAR('\0', out[sizeof(out) - 1]);
}

// M6 #192: runner events (homing results, cycle outcomes) ride the same
// one-line event grammar - {"event":"runner","data":{...},"state":{...}}.
// Kind spellings are the machine contract for host parsers.
void test_runner_event_homing_datum(void) {
  char out[256];
  ApiRunnerData d{};
  d.kind = ApiRunnerEvent::HomingDatum;
  const int n = formatApiRunnerEvent(d, benchSnapshot(), out, sizeof(out));
  TEST_ASSERT_EQUAL_STRING(
      "{\"event\":\"runner\",\"data\":{\"kind\":\"homing_datum\"},"
      "\"state\":{\"posMm\":11.666,\"forceN\":155.71,\"calValid\":true,"
      "\"cycleState\":\"Idle\",\"faultCode\":0,\"homed\":true}}",
      out);
  TEST_ASSERT_EQUAL_INT(static_cast<int>(strlen(out)), n);
}

void test_runner_event_home_top(void) {
  char out[256];
  ApiRunnerData d{};
  d.kind = ApiRunnerEvent::HomeTop;
  d.spanMm = 273.5f;
  formatApiRunnerEvent(d, benchSnapshot(), out, sizeof(out));
  TEST_ASSERT_NOT_NULL(
      strstr(out, "\"data\":{\"kind\":\"home_top\",\"spanMm\":273.50}"));
  d.kind = ApiRunnerEvent::HomeTopNoDatum;
  formatApiRunnerEvent(d, benchSnapshot(), out, sizeof(out));
  TEST_ASSERT_NOT_NULL(strstr(out, "\"kind\":\"home_top_no_datum\""));
}

void test_runner_event_test_summary(void) {
  char out[256];
  ApiRunnerData d{};
  d.kind = ApiRunnerEvent::TestSummary;
  d.peakN = 155.71f;
  d.breakMm = 11.67f;
  d.samples = 598;
  d.truncated = false;
  formatApiRunnerEvent(d, benchSnapshot(), out, sizeof(out));
  TEST_ASSERT_NOT_NULL(strstr(out,
      "\"data\":{\"kind\":\"test_summary\",\"peakN\":155.71,"
      "\"breakMm\":11.67,\"samples\":598,\"truncated\":0}"));
  d.truncated = true;
  d.samples = 8192;
  formatApiRunnerEvent(d, benchSnapshot(), out, sizeof(out));
  TEST_ASSERT_NOT_NULL(strstr(out, "\"samples\":8192,\"truncated\":1"));
}

void test_runner_event_limit_aborted(void) {
  char out[256];
  ApiRunnerData d{};
  d.kind = ApiRunnerEvent::TestLimit;
  formatApiRunnerEvent(d, benchSnapshot(), out, sizeof(out));
  TEST_ASSERT_NOT_NULL(strstr(out, "\"kind\":\"test_limit\""));
  d.kind = ApiRunnerEvent::TestAborted;
  formatApiRunnerEvent(d, benchSnapshot(), out, sizeof(out));
  TEST_ASSERT_NOT_NULL(strstr(out, "\"kind\":\"test_aborted\""));
  // every kind renders the event key first, state last
  TEST_ASSERT_TRUE(
      strncmp(out, "{\"event\":\"runner\",", 18) == 0);
  TEST_ASSERT_EQUAL_CHAR('}', out[strlen(out) - 1]);
}

void test_runner_event_truncation_signalled(void) {
  char out[16];
  ApiRunnerData d{};
  d.kind = ApiRunnerEvent::TestAborted;
  const int n = formatApiRunnerEvent(d, benchSnapshot(), out, sizeof(out));
  TEST_ASSERT_TRUE(n >= static_cast<int>(sizeof(out)));
  TEST_ASSERT_EQUAL_CHAR('\0', out[sizeof(out) - 1]);
}

// NFR: realistic lines stay under the 256 B bound.
void test_length_bound_realistic_lines(void) {
  char out[256];
  const int errLen = formatApiError(
      benchSnapshot(), 0x0603,
      "cycle active: command rejected because a test cycle is running",
      out, sizeof(out));
  TEST_ASSERT_TRUE(errLen > 0 && errLen < 256);
  const int okLen = formatApiSuccess(benchSnapshot(), "{\"reply\":\"ok\"}",
                                     out, sizeof(out));
  TEST_ASSERT_TRUE(okLen > 0 && okLen < 256);
}

// snprintf truncation convention: a too-small buffer signals the
// would-be length (>= cap), never a silent partial line.
void test_truncation_signalled(void) {
  char out[16];
  const int n = formatApiSuccess(benchSnapshot(), "{}", out, sizeof(out));
  TEST_ASSERT_TRUE(n >= static_cast<int>(sizeof(out)));
}

// Negative numbers format through the same locale-neutral path (a
// hanging-mass tare reads negative force, seen on the bench 2026-10-11).
void test_negative_force_renders(void) {
  char out[256];
  ApiStateSnapshot s = benchSnapshot();
  s.forceN = -24.1f;
  formatApiStateJson(s, out, sizeof(out));
  TEST_ASSERT_NOT_NULL(strstr(out, "\"forceN\":-24.10"));
}

// M4 T006 (#210): hold_summary runner event - exact grammar.
void test_runner_event_hold_summary(void) {
  char out[256];
  ApiRunnerData d{};
  d.kind = ApiRunnerEvent::HoldSummary;
  d.holdEnd = "time";
  d.holdTicks = 590;
  d.meanN = 19.44f;
  d.maxDevPct = 52.8f;
  d.inBandPct = 94.2f;
  d.creepMm = 0.097f;
  formatApiRunnerEvent(d, benchSnapshot(), out, sizeof(out));
  TEST_ASSERT_NOT_NULL(strstr(out,
      "\"data\":{\"kind\":\"hold_summary\",\"end\":\"time\","
      "\"ticks\":590,\"meanN\":19.44,\"maxDevPct\":52.8,"
      "\"inBandPct\":94.2,\"creepMm\":0.097}"));
  d.holdEnd = "lost";
  formatApiRunnerEvent(d, benchSnapshot(), out, sizeof(out));
  TEST_ASSERT_NOT_NULL(strstr(out, "\"kind\":\"hold_summary\",\"end\":\"lost\""));
}

void runApiResponseTests() {
  RUN_TEST(test_success_envelope_exact);
  RUN_TEST(test_error_envelope_exact);
  RUN_TEST(test_state_null_members_when_unknown);
  RUN_TEST(test_state_fault_and_cycle);
  RUN_TEST(test_error_message_escaping);
  RUN_TEST(test_event_line_exact);
  RUN_TEST(test_reply_data_exact);
  RUN_TEST(test_reply_data_escapes);
  RUN_TEST(test_reply_data_truncation_signalled);
  RUN_TEST(test_web_command_event_exact);
  RUN_TEST(test_web_command_event_escapes_and_false);
  RUN_TEST(test_web_command_event_truncation_signalled);
  RUN_TEST(test_runner_event_homing_datum);
  RUN_TEST(test_runner_event_home_top);
  RUN_TEST(test_runner_event_test_summary);
  RUN_TEST(test_runner_event_limit_aborted);
  RUN_TEST(test_runner_event_hold_summary);
  RUN_TEST(test_runner_event_truncation_signalled);
  RUN_TEST(test_length_bound_realistic_lines);
  RUN_TEST(test_truncation_signalled);
  RUN_TEST(test_negative_force_renders);
}
