jan-tec/tensile-tester/test/test_config.cpp

// Unit tests for the pure test-cycle configuration (M3 FR-005).
// Run: pio test -e native
//
// TestConfig holds the six operator knobs persisted by Settings (NVS
// namespace testmachine). clampTestConfig() is the single validation
// boundary: NVS values and parser values both flow through it, so the
// runner may trust its input completely afterwards.
#include <unity.h>

#include <FirmwareCore.h>
#include <TestConfig.h>

#include <cmath>
#include <cstring>

void test_default_config(void) {
  const TestConfig c = defaultTestConfig();
  TEST_ASSERT_FLOAT_WITHIN(1e-6f, 12.0f, c.testSpeedMmPerMin);
  TEST_ASSERT_FLOAT_WITHIN(1e-6f, 50.0f, c.armForceN);
  TEST_ASSERT_FLOAT_WITHIN(1e-6f, 50.0f, c.dropPercent);
  TEST_ASSERT_FLOAT_WITHIN(1e-6f, 2.0f, c.homingClearanceMm);
  TEST_ASSERT_FLOAT_WITHIN(1e-6f, 0.0f, c.homingSeekMmPerMin);
  TEST_ASSERT_EQUAL_UINT32(30000, c.homingTimeoutMs);
  // default clamps to itself
  const TestConfig r = clampTestConfig(c);
  TEST_ASSERT_TRUE(memcmp(&r, &c, sizeof(c)) == 0);
}

void test_clamp_speed(void) {
  TestConfig c = defaultTestConfig();
  c.testSpeedMmPerMin = -5.0f;
  TEST_ASSERT_FLOAT_WITHIN(1e-6f, 0.5f, clampTestConfig(c).testSpeedMmPerMin);
  c.testSpeedMmPerMin = 500.0f;
  TEST_ASSERT_FLOAT_WITHIN(1e-6f, 30.0f, clampTestConfig(c).testSpeedMmPerMin);
}

void test_clamp_arm_open_interval(void) {
  TestConfig c = defaultTestConfig();
  c.armForceN = 0.0f;  // (0, 4903] is open at zero: 0 is not a valid arm
  TEST_ASSERT_FLOAT_WITHIN(1e-6f, 50.0f, clampTestConfig(c).armForceN);
  c.armForceN = -3.0f;
  TEST_ASSERT_FLOAT_WITHIN(1e-6f, 50.0f, clampTestConfig(c).armForceN);
  c.armForceN = 9999.0f;  // above the cell's measurable span
  TEST_ASSERT_FLOAT_WITHIN(1e-6f, 4903.0f, clampTestConfig(c).armForceN);
}

void test_clamp_drop_clearance(void) {
  TestConfig c = defaultTestConfig();
  c.dropPercent = 5.0f;
  TEST_ASSERT_FLOAT_WITHIN(1e-6f, 10.0f, clampTestConfig(c).dropPercent);
  c.dropPercent = 95.0f;
  TEST_ASSERT_FLOAT_WITHIN(1e-6f, 90.0f, clampTestConfig(c).dropPercent);
  c.homingClearanceMm = 0.1f;
  TEST_ASSERT_FLOAT_WITHIN(1e-6f, 0.5f, clampTestConfig(c).homingClearanceMm);
  c.homingClearanceMm = 50.0f;
  TEST_ASSERT_FLOAT_WITHIN(1e-6f, 10.0f, clampTestConfig(c).homingClearanceMm);
}

void test_seek_zero_follows_test_speed(void) {
  // FR-005: the seek speed is not an independent knob; 0 (stored or default)
  // means "follow the test speed" and must survive clamping untouched.
  TestConfig c = defaultTestConfig();
  c.homingSeekMmPerMin = 0.0f;
  TEST_ASSERT_FLOAT_WITHIN(1e-6f, 0.0f, clampTestConfig(c).homingSeekMmPerMin);
  TEST_ASSERT_FLOAT_WITHIN(1e-6f, 12.0f, homingSeekSpeed(c));
  c.testSpeedMmPerMin = 30.0f;
  TEST_ASSERT_FLOAT_WITHIN(1e-6f, 30.0f, homingSeekSpeed(c));
  // a nonzero seek speed is clamped to the feed range
  c.homingSeekMmPerMin = 500.0f;
  TEST_ASSERT_FLOAT_WITHIN(1e-6f, 30.0f, clampTestConfig(c).homingSeekMmPerMin);
}

void test_clamp_timeout(void) {
  TestConfig c = defaultTestConfig();
  c.homingTimeoutMs = 0;  // 1 s floor
  TEST_ASSERT_EQUAL_UINT32(1000, clampTestConfig(c).homingTimeoutMs);
  c.homingTimeoutMs = 999999;  // 300 s ceiling
  TEST_ASSERT_EQUAL_UINT32(300000, clampTestConfig(c).homingTimeoutMs);
}

void test_nonfinite_becomes_field_default(void) {
  const TestConfig d = defaultTestConfig();
  TestConfig c = defaultTestConfig();
  const float nan = NAN;
  const float inf = INFINITY;
  c.testSpeedMmPerMin = nan;
  c.armForceN = inf;
  c.dropPercent = -nan;  // sign of NaN must not escape the rule
  c.homingClearanceMm = inf;
  TEST_ASSERT_FLOAT_WITHIN(1e-6f, d.testSpeedMmPerMin,
                           clampTestConfig(c).testSpeedMmPerMin);
  TEST_ASSERT_FLOAT_WITHIN(1e-6f, d.armForceN, clampTestConfig(c).armForceN);
  TEST_ASSERT_FLOAT_WITHIN(1e-6f, d.dropPercent, clampTestConfig(c).dropPercent);
  TEST_ASSERT_FLOAT_WITHIN(
      1e-6f, d.homingClearanceMm, clampTestConfig(c).homingClearanceMm);
}

// M4 T001 (#205): hold config fields - defaults + clamp windows.
void test_hold_config_defaults(void) {
  const TestConfig c = defaultTestConfig();
  TEST_ASSERT_FLOAT_WITHIN(1e-6f, 5.0f, c.holdTolerancePct);
  TEST_ASSERT_FLOAT_WITHIN(1e-6f, 20.0f, c.holdClearanceMm);
}

void test_clamp_hold_fields(void) {
  TestConfig c = defaultTestConfig();
  c.holdTolerancePct = 0.0f;  // below floor -> closed-interval clamp
  TEST_ASSERT_FLOAT_WITHIN(1e-6f, 1.0f,
                           clampTestConfig(c).holdTolerancePct);
  c.holdTolerancePct = 50.0f;
  TEST_ASSERT_FLOAT_WITHIN(1e-6f, 25.0f,
                           clampTestConfig(c).holdTolerancePct);
  c.holdTolerancePct = 7.5f;  // in range stays
  TEST_ASSERT_FLOAT_WITHIN(1e-6f, 7.5f,
                           clampTestConfig(c).holdTolerancePct);
  c.holdClearanceMm = 0.0f;
  TEST_ASSERT_FLOAT_WITHIN(1e-6f, 1.0f, clampTestConfig(c).holdClearanceMm);
  c.holdClearanceMm = 500.0f;
  TEST_ASSERT_FLOAT_WITHIN(1e-6f, 100.0f, clampTestConfig(c).holdClearanceMm);
  c.holdClearanceMm = 33.0f;
  TEST_ASSERT_FLOAT_WITHIN(1e-6f, 33.0f, clampTestConfig(c).holdClearanceMm);
}

void test_hold_nonfinite_becomes_field_default(void) {
  const TestConfig d = defaultTestConfig();
  const float inf = INFINITY;
  const float nanv = NAN;
  TestConfig c = d;
  c.holdTolerancePct = inf;
  c.holdClearanceMm = -nanv;
  TEST_ASSERT_FLOAT_WITHIN(1e-6f, d.holdTolerancePct,
                           clampTestConfig(c).holdTolerancePct);
  TEST_ASSERT_FLOAT_WITHIN(1e-6f, d.holdClearanceMm,
                           clampTestConfig(c).holdClearanceMm);
}

// M4 D7: setpoint magnitude [1, 4000] N, sign preserved; zero is passed
// through for the CALLER to reject (0 N is no command, not a clamp case).
void test_clamp_hold_setpoint(void) {
  TEST_ASSERT_FLOAT_WITHIN(1e-6f, 4000.0f, clampHoldSetpointN(5000.0f));
  TEST_ASSERT_FLOAT_WITHIN(1e-6f, 1.0f, clampHoldSetpointN(0.5f));
  TEST_ASSERT_FLOAT_WITHIN(1e-6f, -4000.0f, clampHoldSetpointN(-5000.0f));
  TEST_ASSERT_FLOAT_WITHIN(1e-6f, -1.0f, clampHoldSetpointN(-0.5f));
  TEST_ASSERT_FLOAT_WITHIN(1e-6f, 50.0f, clampHoldSetpointN(50.0f));
  TEST_ASSERT_FLOAT_WITHIN(1e-6f, -50.0f, clampHoldSetpointN(-50.0f));
  TEST_ASSERT_FLOAT_WITHIN(1e-6f, 0.0f, clampHoldSetpointN(0.0f));
}

// #220: the per-sample ceiling rides the config boundary.
void test_hold_max_ceiling(void) {
  const TestConfig d = defaultTestConfig();
  TEST_ASSERT_FLOAT_WITHIN(1e-6f, 4000.0f, d.holdMaxN);
  TestConfig c = d;
  c.holdMaxN = 0.0f;
  TEST_ASSERT_FLOAT_WITHIN(1e-6f, 1.0f, clampTestConfig(c).holdMaxN);
  c.holdMaxN = 99999.0f;
  TEST_ASSERT_FLOAT_WITHIN(1e-6f, 4000.0f, clampTestConfig(c).holdMaxN);
  c.holdMaxN = 100.0f;
  TEST_ASSERT_FLOAT_WITHIN(1e-6f, 100.0f, clampTestConfig(c).holdMaxN);
  // The effective setpoint honors the ceiling, sign preserved.
  TEST_ASSERT_FLOAT_WITHIN(1e-6f, 100.0f, effectiveHoldSetpointN(99999.0f, c));
  TEST_ASSERT_FLOAT_WITHIN(1e-6f, -100.0f, effectiveHoldSetpointN(-500.0f, c));
  TEST_ASSERT_FLOAT_WITHIN(1e-6f, 50.0f, effectiveHoldSetpointN(50.0f, c));
  TEST_ASSERT_FLOAT_WITHIN(1e-6f, 0.0f, effectiveHoldSetpointN(0.0f, c));
}

void runConfigTests(void) {
  RUN_TEST(test_default_config);
  RUN_TEST(test_clamp_speed);
  RUN_TEST(test_clamp_arm_open_interval);
  RUN_TEST(test_clamp_drop_clearance);
  RUN_TEST(test_seek_zero_follows_test_speed);
  RUN_TEST(test_clamp_timeout);
  RUN_TEST(test_nonfinite_becomes_field_default);
  RUN_TEST(test_hold_config_defaults);
  RUN_TEST(test_clamp_hold_fields);
  RUN_TEST(test_hold_nonfinite_becomes_field_default);
  RUN_TEST(test_clamp_hold_setpoint);
  RUN_TEST(test_hold_max_ceiling);
}
