jan-tec/tensile-tester/(commit log)

2026-04-12 added menu for calibration and measurement with loadcell - not tested yet
2026-04-13 added move motor function
2026-04-14 Added Calibration to Web Interface
2026-08-19 fix: complete serial command help list (pos, jog, cal_* were missing) (#2)
    [main.cpp]
2026-08-20 chore: apply over-engineering audit cuts (#3)
    * chore: remove dead TestMode scaffolding, unused TMC libs, merge duplicate step helpers
    * fix: address review - stale README/CHANGELOG testMode refs, indentation drift
    ---------
    [main.cpp]
2026-08-20 feat: TDD foundation - FirmwareCore lib, native Unity tests, CI test job (#5)
    Extract pure gear/feed math from src/main.cpp into lib/FirmwareCore
    (platform-independent C++). Characterized behavior first with 10 Unity
    tests in test/test_gear_math.cpp, then moved the implementation.
    - [env:native] in platformio.ini (platform=native, test_framework=unity);
    'pio test -e native' is the local primary gate, 'pio run -e esp32dev'
    the compile gate
    - CI gains a separate 'test' job (host unit tests) next to 'build'
    - AGENTS.md: Testing section switched to full TDD policy (RED/GREEN/
    REFACTOR on host, FreeRTOS/portMUX/NVS/driver timing stay target-tested)
    Local verification: 10/10 tests passed,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
2026-08-20 feat(core): pure command parser in FirmwareCore (M0-T002) (#40)
    * test(core): RED - command parser tests + shared Unity runner (M0-T002)
    - test/test_command_parser.cpp: 10 tests pinning legacy parse semantics
    (case-sensitive names, prefix without word boundary, comma decimal,
    non-numeric -> 0.0)
    - test/test_gear_math.cpp: main() -> runGearMathTests()
    - test/test_main.cpp: single Unity entry point (PlatformIO links all
    test files into one binary)
    Suite fails to compile: commandFromName/parseCommandValue not yet in
    FirmwareCore.
    * feat(core): pure command parser in FirmwareCore (M0-T002)
    GREEN for the RED suite from the previous commit:
    - enum class Command: the 10 value-less comman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
    [test_command_parser.cpp, test_gear_math.cpp, test_main.cpp]
2026-08-20 docs: No-Quirk Policy (NQP) - pin, track, fix (#44)
    - AGENTS.md: NQP section (pin in test -> [NQP] issue in Quirks milestone ->
    behavior-change PR; one quirk per PR, never inside behavior-preserving
    refactors)
    - specs/README.md: Quirks milestone row (#41-#43) + NQP pointer
    First quirk batch filed from M0-T002 (PR #40): #41 #42 #43.
2026-08-20 refactor(motion): extract Motion module (M0-T003, #10) (#45)
    Move AccelStepper control, the core-0 motor task, the portMUX and
    all stepper access out of src/main.cpp into src/Motion.{h,cpp}:
    - begin(): pins, AccelStepper config, initial rpm (12 mm/min), task
    - enable()/disable()/stop()/zero()
    - setOutputRpm()/setAccelRpmPerS() + settings apply
    - startMoveToSteps(): legacy startMoveTo (implicit enable)
    - isRunning()/steps()/positionMm()/isEnabled()
    main.cpp keeps pins/loadcell/WiFi/WebServer/CLI/web-UI only.
    Behavior preserved (FR-004): no response strings, no pin state,
    no JSON field changed. One internal ordering note: the motor task
    now starts in motion.begin() (before the delay(500) ban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
2026-08-20 refactor(firmware): extract HX711 loadcell into LoadCell module (M0-T004) (#47)
    Behavior-preserving extraction per M0 FR-004: HX711 driver, 10 Hz
    sample + low-pass filter, NVS calibration (testmachine namespace,
    lc_valid/lc_factor keys), tare, and the two-step calibration flow
    (zero-point capture + known-mass apply) move from src/main.cpp into
    src/LoadCell.{h,cpp}.
    main.cpp keeps the command handlers and the German response strings;
    cal_apply maps LoadCell::CalError to the legacy responses.
    Gates: pio test -e native 20/20; pio run -e esp32dev SUCCESS; target
    smoke 12/12 (boot diagnostics, force, tare, zero, cal_zero, cal_apply
    error paths, periodic status).
    Refs #11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
    [LoadCell.cpp, LoadCell.h, main.cpp]
2026-08-20 refactor(firmware): extract NVS calibration into Settings module (M0-T005) (#49)
    * feat(settings): add Settings module with NVS calibration access (M0-T005, step 1/2)
    New NVS facade owning the Preferences namespace 'testmachine' and the
    calibration keys (lc_valid / lc_factor). loadCalibration() preserves
    the legacy invalid-or-zero fallback (reset to factor 1.0);
    saveCalibration() writes factor + valid flag. Not yet consumed.
    * refactor(loadcell): consume Settings for NVS calibration (M0-T005, step 2/2)
    Behavior-preserving (M0 FR-004): LoadCell::begin(Settings&) takes the
    NVS dependency via pointer; the Preferences member, the two NVS
    functions and the four NVS constants move out of LoadCe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
    [LoadCell.cpp, LoadCell.h, Settings.cpp, Settings.h, main.cpp]
2026-08-20 refactor(firmware): extract command policy into Commands module (M0-T006) (#50)
    * feat(commands): add Commands module with command policy (M0-T006, step 1/2)
    Moves the executeCommand() policy out of main.cpp into src/Commands:
    dispatch, validation, German response text, help list, printPosition.
    Name matching uses the T002 parser (commandFromName); value parsing
    uses parseCommandValue via a String adapter. Behavior byte-identical
    to the legacy inline dispatch (FR-004): quirks #41/#42/#43 preserved,
    not fixed. JOG_TRAVEL_MM moves in as Commands::kJogTravelMm.
    Not yet consumed by main.cpp.
    * refactor(commands): use Commands module, drop inline policy (M0-T006, step 2/2)
    Behavior-preserving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
    [Commands.cpp, Commands.h, main.cpp]
2026-08-20 refactor(firmware): extract serial input loop into SerialCli module (M0-T007) (#51)
    * feat(serialcli): add SerialCli module with serial input loop (M0-T007, step 1/2)
    Moves the handleSerialInput() line-accumulation logic (CR skip, LF
    dispatch, unknown-command help) out of main.cpp into src/SerialCli.
    Owns the line buffer; dispatches through Commands. Not yet consumed by
    main.cpp.
    * refactor(serialcli): use SerialCli module, drop inline input loop (M0-T007, step 2/2)
    Behavior-preserving (M0 FR-004): handleSerialInput() and the global
    serialBuffer move into src/SerialCli; loop() now calls serialCli.poll().
    CR skip, LF dispatch and the unknown-command help print are unchanged.
    Co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
    [SerialCli.cpp, SerialCli.h, main.cpp]
2026-08-21 refactor(firmware): extract App module, main.cpp to composition root (M0-T009) (#53)
    * feat(app): add App module with boot sequence and main loop (M0-T009, step 1/3)
    Moves the setup()/loop() orchestration out of main.cpp into src/App:
    Serial/Motion/banner/LoadCell/Web boot order in begin(), Web serving +
    loadcell sampling + serial input + periodic status print in loop().
    DI on all six modules; STATUS_INTERVAL_MS and lastStatusMs become
    private. Not yet consumed by main.cpp.
    * refactor(app): main.cpp becomes composition root (M0-T009, step 2/3)
    Behavior-preserving (M0 FR-004): setup()/loop() bodies move into
    App; main.cpp keeps only the global module wiring (construction order
    unchanged) a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
2026-08-21 refactor(firmware): IMotion/ILoadCell contracts + App reference injection (M0-T010) (#54)
    * feat(interfaces): add IMotion and ILoadCell contracts (M0-T010, step 1/4)
    FR-007: pure-virtual contracts mirroring the public API that emerged in
    M0-T003/T004 (plan.md section 3 sketch adapted: begin(Settings&),
    forceNewton() naming, getters included; CalError moved onto the
    contract since it names calibration failure modes any implementation
    must promise). No dynamic allocation - consumers hold references to
    statically created objects. Not yet implemented by anything.
    * refactor(motion): Motion implements IMotion (M0-T010, step 2/4)
    Header-only change: inherit the contract and mark the 14 public
    m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
    [App.h, ILoadCell.h, IMotion.h, LoadCell.h]
2026-08-21 fix(firmware): require word boundary after value-command prefix (#42) (#56)
    'rpmx 5' / 'accident 5' / 'movable 2' no longer dispatch as 'rpm' / 'acc' /
    'move' (NQP #42). parseCommandValue() now rejects the match unless the
    character after the prefix is whitespace or end-of-string; the FR-004 quirk
    pin in test_command_parser.cpp is replaced by the new expectation in the
    same PR. Behavior change: explicit per the No-Quirk Policy.
    [test_command_parser.cpp]
2026-08-21 fix(firmware): reject negative calibration factor in cal_apply (NQP #46) (#57)
    * refactor(firmware): extract calibration compute into FirmwareCore (NQP #46 prep)
    calibrationFactorFromMass() + verifyCalibrationFactor() (legacy zero-only
    policy) move from LoadCell::calibrateWithMass into lib/FirmwareCore with
    host tests pinning the formula and the quirk (negative factors accepted).
    Behavior-preserving; named *FromMass* to avoid hiding the LoadCell getter.
    * fix(firmware): reject negative calibration factor in cal_apply (#46)
    A reading below the HX711 offset (noisy cell, temperature drift, or the
    part disturbed between cal_zero and cal_apply) produced a negative
    calibration factor that was s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
    [Commands.cpp, ILoadCell.h, LoadCell.cpp, test_calibration.cpp, test_main.cpp]
2026-08-21 fix(firmware): full-token validation in value-command parsing (NQP #43) (#58)
    * test(firmware): NQP #43 RED - expect InvalidValue for garbage/truncated values
    Replaces the FR-004 pin 'non_numeric_is_zero' (rpm abc -> 0.0) with the
    new tri-state expectations: ParseResult::{NotACommand, InvalidValue, Ok}.
    Full-token validation (strtof endptr), non-finite rejection, and the
    acceptance cases (rpm 5, feed 12,5, move -2; rpm <empty> stays unknown).
    * fix(firmware): full-token validation in value-command parsing (#43)
    Legacy String::toFloat()/strtof mapped non-numeric input to 0.0 (the user
    got the misleading 'RPM muss groesser als 0 sein' for 'rpm abc') and
    truncated trailing junk ('rpm 5abc' s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
    [Commands.cpp, Commands.h, test_command_parser.cpp]
2026-08-21 feat(m1): pure DeviceModel state machine (M1-T001, #20) (#60)
    Booting -> SelfTest -> Idle | Error in FirmwareCore (no Arduino).
    Events: SelfTestStart, CheckResult, SelfTestDone, PowerLow, Reset.
    FAIL check / power fault -> Error with the triggering machine code;
    first fault wins; Reset is the only exit (FR-009 recovery path).
    TC-001: full 4x5 transition table pinned RED-first in
    test/test_device_model.cpp (10 tests, 36/36 native green).
    [test_device_model.cpp, test_main.cpp]
2026-08-21 feat(m1): pure HealthEval helpers (M1-T002, #21) (#61)
    Power rail evaluation per FR-005: powerStatusForVoltage (FAIL < 4.50 V,
    WARN < 4.75 V), PowerMonitor with 5-sample FAIL debounce and hysteresis
    band at the fail boundary (band samples neither extend nor clear the
    streak; recovery demotes Fail -> Warn/OK). HX711 500 ms variance window
    (FR-006): SampleWindow (50 samples @ 10 Hz) with spread() and the
    HX711_NO_VARIATION_SPREAD diagnostic threshold. TC-002 pinned RED-first
    in test/test_health_eval.cpp (13 tests, 49/49 native green).
    [test_health_eval.cpp, test_main.cpp]
2026-08-21 feat(m1): ErrorCode vocabulary for selftest checks (M1-T003, #22) (#62)
    src/ErrorCode.h: stable machine codes (enum class ErrorCode : uint16_t)
    in the FR-003 blocks 0x01xx NVS / 0x02xx power / 0x03xx HX711 / 0x04xx
    motor, the CheckStatus enum (OK/WARN/FAIL/NOT_CONNECTED/NOT_WIRED), the
    CheckId set (FR-002) and the CheckResult struct (FR-003 result shape)
    plus the stable English string names used by the FR-007 log grammar and
    /api/status. Pure declarations, no Arduino.h; absence codes stay
    warning/info per plan D3. Codes are frozen once published - append only.
    [ErrorCode.h]
2026-08-21 feat(M1-T004): Diagnostics boot self-test with BOOT/CHECK/STATE log grammar (#63)
    - Diagnostics module (src/): boot self-test per M1 FR-001..FR-004,
    FR-007: prints BOOT fw=<ver> git=<sha8> reset=<reason>, CHECK lines
    per check, STATE lines on every device-state transition; disables the
    motor driver on fault (device model in Error).
    - BOARD check: free heap + flash size sanity (WARN-only, D3).
    - NVS check: raw calibration read via new Settings::readRawCalibration();
    corrupt flag/factor combo reports NvsCalibrationCorrupt WARN.
    - FirmwareCore: deviceStateName() (pure, host-tested, default arm).
    - Build hook scripts/build_git_sha.py (extra_scripts pre) generates
    include/git_sha.h so G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
    [App.cpp, App.h, Diagnostics.h, Settings.cpp, Settings.h, main.cpp]
2026-08-21 feat(diagnostics): HX711 boot check + force n/a when not ready (M1 T005) (#64)
    - Diagnostics::checkHx711(): wait_ready(1000 ms) -> NotConnected (D3: WARN
    class, no code); else two raw samples 500 ms apart, spread vs
    HX711_NO_VARIATION_SPREAD (pinned in lib/FirmwareCore,
    test_health_eval.cpp) -> Warn Hx711NoVariation (0x301) or Ok.
    - ILoadCell/LoadCell gain waitReady(timeoutMs) + rawSample(int32_t&):
    selftest primitives, independent of the isReady() state (which belongs
    to begin()/poll(); the selftest reports via CheckResult).
    - runBootSelfTest(Settings&, ILoadCell&, IMotion&); check order BOARD,
    NVS, HX711 (MOTOR T006, POWER T007). WARN dispatches code 0 to the
    model, so a no-v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
2026-08-21 feat(diagnostics): MOTOR boot check via EN toggle (M1 T006) (#65)
    - Diagnostics::checkMotor(): toggle EN (disable -> enable), verify the
    module state follows, restore the pre-check state (boot default:
    disabled, FR-001 driver off).
    - D5: no sense wiring exists, so the EN line is never read back; the
    result carries MotorNoFeedback (0x0401) as an info note on every
    outcome - a clean OK without it would be a false positive. A state
    machine that does not follow the toggle is FAIL (dispatched to the
    model, driver stays off).
    - Check order BOARD, NVS, HX711, MOTOR (POWER is T007).
    - No new host tests: the decision is trivial and plan.md section 5 maps
    T003-T011 to existing-suite-gree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
    [Diagnostics.h]
2026-08-21 feat(diagnostics): POWER boot check + 1 Hz rail monitor (M1 T007) (#66)
    FR-005/D4: 10 k/10 k divider 5 V rail -> GPIO34 (INPUT_PULLDOWN),
    rail-equivalent volts = 2 x ADC volts.
    - PowerSense adapter: begin/readRailVolts/poll (1 Hz), owns a pure
    PowerMonitor (hysteresis/debounce pinned in test_health_eval.cpp).
    - Diagnostics::checkPower: powerNotWired (< 1.0 V, new pure helper)
    -> NOT_WIRED info (D3, no code, no model fault); else
    powerStatusForVoltage -> OK/WARN/FAIL with PowerLow 0x201 on fail.
    Boot check order per plan: BOARD, NVS, POWER, HX711, MOTOR.
    - Runtime: App polls PowerSense at 1 Hz; Diagnostics forwards a
    debounced Fail to the DeviceModel (PowerLow -> Error, FR-009
    re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
    [App.cpp, App.h, Diagnostics.h, PowerSense.cpp, PowerSense.h, main.cpp, test_health_eval.cpp]
2026-08-21 feat(app): FR-009 Error-state behavior (M1 T009) (#67)
    Error state per spec: driver disabled, motion commands rejected with
    code + message, recovery by reset/reboot.
    - New pure isMotionCommand() in FirmwareCore (RED first): en/off/zero/
    stop/jog up|down + the rpm/acc/feed/move/turn value prefixes with the
    NQP #42 word-boundary rule; pos/force/tare/cal_* stay usable.
    4 new host tests, 55/55.
    - Refactor: the #42 boundary check is extracted into
    startsWithCommandPrefix() and shared by parseCommandValue (behavior
    unchanged, pinned by the existing parser tests).
    - Commands::execute(): in DeviceState::Error, motion commands are
    rejected with "Fehlerzustand (Code 0xNNNN): Motorkommando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
    [App.cpp, App.h, Commands.cpp, Commands.h, main.cpp, test_command_parser.cpp]
2026-08-21 feat(webui): FR-008 selftest presentation - /api/status object + panel (M1 T010) (#68)
    - New pure overallStatus() in src/ErrorCode.h (RED first, 5 host tests,
    60/60): any FAIL dominates, otherwise any WARN; NOT_WIRED /
    NOT_CONNECTED are info only (D3) and never lower the rating.
    - /api/status now carries "state" (deviceStateName), "faultCode"
    (numeric) and the FR-008 selftest object:
    {"overall":"WARN","checks":[{id,status,errorCode,measurement,
    elapsedMs}, ...]} using the stable FR-003 machine names.
    WebUi takes a Diagnostics& (main.cpp wires it after Diagnostics is
    constructed).
    - Web UI: new "Selbsttest" card (German ASCII labels per convention):
    overall/state/fault-code pi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
    [ErrorCode.h, UiHtml.h, WebUi.cpp, WebUi.h, main.cpp, test_error_code.cpp, test_main.cpp]
2026-08-21 docs(m1): T011(a) no-wiring target matrix + power-check reference (#69)
    - New docs/hardware-power-check.md: build + verify the 10 k/10 k rail
    divider on GPIO34 (unblocks #27), expected reading table
    (NOT_WIRED < 1.0 V, FAIL < 4.50, WARN < 4.75, OK >= 4.75 rail-
    equivalent), runtime monitor semantics (5-sample debounce, 50 mV
    hysteresis), and troubleshooting.
    - TC-003(a) captured on the bench 2026-08-21 (no wiring): boot log +
    observed-vs-expected table. All rows match; SC-001 verified (Idle at
    t=1.040 s, warnings only).
    - SC-001 + plan check table correction: the spec expected HX711
    NOT_CONNECTED, but the actual bench has the load cell wired, so the
    observed status is WARN HX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
2026-10-05 added en2 for second motor
2026-10-07 fix(test): pin gnu++17 for env:native (#73)
    AppleClang (macOS) defaults to C++98 and rejects constexpr/enum class,
    so the host test env errored locally while Linux CI (gcc, gnu++17
    default) stayed green. An explicit build flag makes the native env
    compiler-independent. No firmware change (esp32dev env untouched).
2026-10-07 feat(m2-t001): FirmwareCore Locale resolution (TC-001) (#74)
    * fix(test): pin gnu++17 for env:native
    * test(m2-t001): RED locale resolution tests (TC-001)
    Failing first: localeFromName (en/de parse, NULL/empty/unknown -> En
    default) + resolveMsgTable (0=EN, 1=DE; missing DE entry falls back to
    EN). Suite is ERRORED until FirmwareCore gains the Locale API.
    * feat(m2-t001): FirmwareCore Locale resolution (TC-001)
    Minimal G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
    [test_locale.cpp, test_main.cpp]
2026-10-07 feat(motion): smooth stepper motion via FastAccelStepper (RMT) + 3 MB app partition (#71)
    * perf(webui,firmwarecore): share steps->mm helper, tune status JSON
    Add spindleMmFromSteps() (inverse of spindleMmToSteps) so the steps->mm formula lives in one place, and read steps() once in statusJson() so "steps" and "positionMm" cannot disagree mid-move. Reserve the status JSON buffer for its ~740 B payload.
    * feat(motion): drive stepper via FastAccelStepper (RMT)
    Replace the AccelStepper polling task (core 0 + portMUX, 200us delay + a periodic 1ms vTaskDelay) with FastAccelStepper, which generates steps on the ESP32 RMT peripheral in hardware. Step timing is no longer jittered by WiFi/schedule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
    [WebUi.cpp, test_gear_math.cpp]
2026-10-07 docs(spec): M3 automated tensile test cycle (#75)
    * docs(spec): M3 automated tensile test cycle
    Spec-Anchored feature spec: one-command test (home on D25 endstop, pull
    up at test speed, peak-drop break detection, 10 Hz sampling, guarded
    stop on D26 top limit) + USB serial CSV data API for host-side plotting.
    Anchors: YZC-516C 500 kg (4903 N) load cell, FastAccelStepper
    forceStop/getCurrentPosition, HX711 10 SPS timing, 64 KB sample buffer.
    Clarify round complete; next: /spec.plan.
    * docs(spec): M3 anchors - KW4-3Z-3 endstops + YZC-516C load cell
    A1: YZC-516C S-type 500 kg = 4903 N, 2.0 mV/V -> 10 mV FS; testarm 50 N
    (~1% FS, ~50x HX711 10 SPS noise floor), testdrop 50%.
    A2: KW4-3Z-3 SPDT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
2026-10-07 docs(spec): M4 constant-force hold (creep-style test) (#77)
    A2: KW4-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
2026-10-07 docs(spec): M5 load cell calibration + M6 structured serial API (#78)
    (~1% FS, ~50x HX711 10 SPS noise floor), testdrop 50%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
2026-10-07 docs(spec): back #81/#82/#83 with research - homing, calibration rev 2, web UI (#84)
    * docs(spec): back #81/#82/#83 with research - homing, calibration rev 2, web UI
    #81 -> M3: FR-001 upgraded to GRBL two-stage homing (fast seek ->
    clearance back-off -> slow re-seek = debounce/entprellen); new FR-008
    home top (positioning utility, datum unchanged); test skips re-homing
    when already homed (operator inserts sample after homing); TC-007.
    #82 -> M5 rev 2: cal_suggest + max-force register + data-driven basis
    DROPPED (owner redirect: guidance moves to documentation); new guided
    wizard calibrate <grams> (PromptHang/Measuring/PromptRemove/ZeroCheck,
    cal_next confirm, settled-window averaging); manu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
2026-10-07 docs(hygiene): betterleaks config, dead option removal, calibration guide (#85)
    Closes #79: .betterleaks.toml ([extend] useDefault = true, .pio/
    allowlist for third-party dep docs, README softAP credential
    allowlisted). Verified: working-tree scan clean, dummy secret in an
    untracked file still caught (generic-password rule). Note: betterleaks
    default set has no AWS-key rule - verified empirically.
    Closes #80: dead test_include_dir option removed from [env:native]
    (unknown-option warning gone; PIO default layout already puts src/ on
    the test include path). 70/70 host tests + esp32dev build green.
    Also: M2 FR-008 AGENTS.md convention swap (locale-table rule replaces
    ASCII-transcription), doc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
2026-10-09 feat(m2-t002): Text.h EN/DE message tables (TC-002) (#87)
    * test(m2-t002): RED - Text table completeness (TC-002)
    Host test for the M2 TC-002 gate: every Msg id needs a non-empty EN and DE
    entry, EN/DE tables parallel and sized to Msg::Count. Suite ERRORED as
    expected (Text.h does not exist yet) - TDD RED step, T002 #32.
    * feat(m2-t002): Text.h EN/DE message tables (TC-002 GREEN)
    56 Msg ids with parallel EN/DE columns: EN is the default locale (FR-001),
    DE reproduces the strings currently in the modules byte-for-byte and stays in
    the ae/oe/ue/ss transcription FR-006 requires for serial (the ae/oe/ue variant
    for web DE is owned by the T005 JS dictionary, D5). Values and units are
    separate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
    [Text.cpp, Text.h, test_main.cpp, test_text_tables.cpp]
2026-10-09 docs(spec): M3 implementation plan + task breakdown (contracts first) (#91)
    * docs(spec): M3 implementation plan + task breakdown (contracts first)
    plan.md: architecture split (pure FirmwareCore decision logic vs src/ hardware
    glue), key decisions D1-D13, data model with NVS keys, the C++ contracts for
    TestCycleModel / HomingModel / BreakDetector / SampleBuffer+CSV / TestConfig,
    the new 0x05xx endstop error block, the B1-B8 bench matrix and the M2/#37/#88
    sequencing dependencies.
    tasks.md: 14 tasks (T001-T007 pure RED-first, T008-T013 target, T014 bench),
    100% FR/TC/SC/US coverage verified by script.
    Also records a latent bug found while planning: WebUi::statusJson() gathers the
    selftest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
2026-10-10 fix(powersense): drop INPUT_PULLDOWN on GPIO34 (input-only pad) (#92)
    GPIO34-39 have no internal pull-up/pull-down. Requesting INPUT_PULLDOWN made
    the IDF driver log an error on every boot and applied nothing:
    E (537) gpio: gpio_pulldown_en(123): GPIO number error (input-only pad has no internal PD)
    Plain INPUT is the only legal mode on that pad. The functional consequence is
    documented rather than papered over: the D3 assumption 'an absent divider reads
    ~0 V because the pin is pulled down' was never true, so NOT_WIRED on an unwired
    board is best effort (bench reading 0.28 V rail-equivalent) until the divider
    provides the defined level (#27). docs/hardware-power-check.md now says so.
    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
    [PowerSense.cpp, PowerSense.h]
2026-10-10 fix(web): clear the stale status error once polling recovers
    refreshStatus() set 'Status kann nicht geladen werden.' on any failed poll and
    nothing ever cleared it. One dropped request out of the 10 Hz poll - which the
    SoftAP does produce, observed once in ~70 s on the bench - left a red connection
    error on screen indefinitely, next to pills that kept updating. On a machine
    control page that is a false alarm the operator has to interpret, and it also
    hides the reply of the next successful poll until a button is pressed.
    The flag is set in the catch and cleared on the first success, so the message
    covers the outage window and disappears with it. No new strings, no state beyond
    one boolean.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
    [UiHtml.h]
2026-10-10 fix(web): inline favicon, first host test for the HTML asset (#59) (#93)
    Every page load logged a 404: the browser asks for /favicon.ico and the
    firmware never served one. Declaring an inline SVG data URI removes the request
    (and the console error) without adding a route or a partition.
    UiHtml.h gains an Arduino-guarded PROGMEM definition so the header can be
    included by the native test build - same pure-header pattern as ErrorCode.h and
    Text.h. test/test_ui_html.cpp then pins the asset: charset/lang, the inline
    icon, and the control-wiring attributes (data-cmd / data-jog / data-prefix) that
    the JS looks up by name.
    [UiHtml.h, test_main.cpp, test_ui_html.cpp]
2026-10-10 fix(web): keyboard jog, aria-labels, live message region (#94)
    Measured on the bench board: with a jog button focused, Enter and Space produced
    zero /api/command requests - the controls are wired to pointer events only, so a
    keyboard operator cannot jog the crosshead at all (WCAG 2.1.1).
    keydown/keyup now mirror press-and-hold, with the two safety properties of the
    pointer path kept: auto-repeat does not re-send the start command, and blur stops
    the jog the way pointerleave does - otherwise a key released after the page lost
    focus would leave the machine running. Space keeps its preventDefault so it does
    not scroll the page.
    Both jog buttons are a bare glyph (U+25B2 / U+25BC), so they got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
    [UiHtml.h, test_ui_html.cpp]
2026-10-10 docs(agents): push guardrail for agent sessions (#100) (#101)
    Records why 165c0ac reached main without a PR and the four rules that prevent
    repeating it, including the verified audit one-liner and its current baseline
    (10 unnumbered non-merge commits, 9 of them older than the PR-flow agreement).
    Every command in the table was run before being written down; the first draft
    carried a nonexistent 'git log --merges=no-merges' flag.
2026-10-10 feat(core): BreakDetector for break detection (T001) (#104)
    M3 T001, FR-003/TC-002. Pure arm/peak/drop detector in lib/FirmwareCore:
    arms strictly above the arm threshold, tracks the running peak only while
    armed, latches Broken when a sample falls strictly below dropFraction of
    the peak, ignores NaN and inf entirely, and is resettable so it can be
    reused across test runs. No Arduino, no heap - host-tested RED-first.
    [test_break_detect.cpp, test_main.cpp]
2026-10-10 fix(diagnostics): pad error codes to 4 hex digits in BOOT logs (97) (#105)
    Serial.print(v, HEX) drops leading zeros, so a CHECK/STATE line printed
    `code=0x301` instead of the FR-007 grammar's `0x0301` - fixed-width log
    parsers on the host lost the column. New pure errorCodeHex() helper in
    ErrorCode.h (host-tested) is now the single padding point; Commands
    already used %04X and the web client already pads in JS.
    Refs #97
    [ErrorCode.h, test_error_code.cpp]
2026-10-10 fix(text): generate Msg enum and EN/DE table from one X-macro list (#88) (#107)
    [Text.h, test_text_tables.cpp]
2026-10-10 feat(core): HomingModel staged homing FSM (T002) (#108)
    Pure C++ header-only HomingModel in lib/FirmwareCore/src/Homing.h:
    BackOff -> SeekDown -> FinalSeek -> Done for bottom (datum) homing,
    SeekUp -> BackOffDown -> Done for `home top` (never a datum).
    FR-001, FR-008, TC-006, TC-007. No Arduino, no heap, injected time.
    Pinned semantics the contract left open (questions -> what the tests pin):
    | Question | Pin |
    |----------|-----|
    | Where does the oneStepMm tolerance apply? | A guarded distance D is CONSUMED once measured travel >= D - oneStepMm; absorbs step quantisation so an ideal run's stage-2 trigger lands exactly on the stage-1 trigger position (datum identity, TC-007) |
    | Trigger and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
    [test_homing_model.cpp, test_main.cpp]
2026-10-10 test(locale): drift gate - translation allowlist + stale/raw literal scanner (M2-#89) (#113)
    [Text.h, test_text_tables.cpp]
2026-10-10 fix(web): selftest overall from real check array, kMaxChecks contract, honest reserve (#90) (#115)
    [Diagnostics.h, WebUi.cpp, test_error_code.cpp]
2026-10-10 test(web): data-cmd/data-prefix vs parser cross-check (#98) (#116)
    * fix(web): selftest overall from real check array, kMaxChecks contract, honest reserve (#90)
    * test(web): data-cmd/data-prefix vs parser cross-check (#98)
    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
    [test_ui_html.cpp]
2026-10-10 fix(web): visible locale-aware labels for numeric inputs, dup-key guard (#99) (#117)
    [UiHtml.h, test_ui_html.cpp]
2026-10-10 feat(core): 0x05xx endstop error block 0x0501-0x0504 (M3-T006, #122) (#123)
    [ErrorCode.h, test_error_code.cpp]
2026-10-10 feat(core): TestConfig defaults + clampTestConfig validation boundary (M3-T005, #118) (#124)
2026-10-10 feat(core): home/home top/test commands + data index parser (M3-T007, #121) (#125)
    * feat(core): TestConfig defaults + clampTestConfig validation boundary (M3-T005, #118)
    * feat(core): home/home top/test commands + data index parser (M3-T007, #121)
    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
2026-10-10 feat(core): SampleBuffer + exact-once CSV chunk formatter (M3-T004, #120) (#127)
2026-10-10 chore(hardware): import Mainboard-ATLAS KiCad CAD sources (#129)
    * chore(hardware): import Mainboard-ATLAS KiCad CAD sources
    Imported from untracked raw/ (designer's KiCad 9 project): schematic,
    PCB, custom symbols/footprints, lib tables, gerbers (fab record).
    Dropped: DS_Store, lock files, fp-info-cache, .bak, 28 backup zips,
    predecessor Experiment board zip. Import documented in
    hardware/mainboard-atlas/README.md. Tools: kicad-cli (brew cask),
    kiutils (.venv).
    * chore(hardware): stop tracking .kicad_prl (kicad-cli rewrites it)
    KiCad treats .kicad_prl as per-user local prefs; kicad-cli 10 mutates it
    on every netlist export (prototype_zone_fills, git.integration_disabled
    defaults). Ignore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
    [Mainboard-ATLAS-B_Cu.gbl, Mainboard-ATLAS-B_Mask.gbs, Mainboard-ATLAS-B_Silkscreen.gbo, Mainboard-ATLAS-Edge_Cuts.gm1, Mainboard-ATLAS-F_Cu.gtl, Mainboard-ATLAS-F_Mask.gts, Mainboard-ATLAS-F_Silkscreen.gto, Mainboard-ATLAS-job.gbrjob]
2026-10-10 spec(m8): LED status language (GPIO2) - research-anchored spec (#130)
    * spec(m8): LED status language - WCAG-safe patterns, layered FSM, gamma PWM
    Research-anchored (2026-10-10): WCAG 2.3.1 <=3 flashes/s (supersedes #128
    draft timings which sat at 4-8 Hz), OpenShock prioritized-pattern practice,
    gamma-2.2 PWM brightness. Pure LedPattern FSM in FirmwareCore + thin
    LedStatus driver (#128).
    * spec(m8): review fixes - gamma duties corrected, pattern-uniqueness scoped to emission windows
    Review of PR #130: FR-006 duties were 0.3/13/36%, actual level^2.2 =
    2.9/13.3/32.5%. FR-004 claimed overlays never equal a base pattern but
    endstop-vs-SelfTest and break-vs-Homing share shapes; now scoped hone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
2026-10-10 feat(m8): LedPattern FSM (pure) + TC-101 flash-rate invariant (M8-T001) (#138)
    * spec(m8): implementation plan + task breakdown (#128)
    ASAP path for endstop->LED bench feedback: T001 pure FSM -> M3-T008
    Endstops pulled forward (D1, independent in M3 graph) -> T002 driver +
    wiring -> flash + bench B1-B3. Break/cal events (T003) wait on M3-T011.
    * test(m8): RED - LedPattern contracts + TC-101 flash-rate invariant (#132)
    Virtual-clock walks of all 5 base patterns, overlay 2-reps/latest-wins,
    Error suppression, gamma duty table, TC-101 <=3 rising edges per 1000 ms
    over every base and overlay pattern.
    * feat(m8): LedPattern FSM - base patterns, overlays, gamma duties, TC-101 (#132)
    GREEN: 18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
    [test_led_pattern.cpp, test_main.cpp]
2026-10-10 feat(m3): Endstops input module GPIO 25/26 + App poll (T008, #133) (#139)
    INPUT_PULLUP, COM+NC (pressed = HIGH), 5 ms sample cadence, 3-sample
    debounce, rising edges cleared on read, bootState snapshot for the
    T013 selftest rows. Pulled forward per M8 plan D1: it is the LED
    endstop overlay's input source (M8-T002 #134). Bench read-back happens
    with M8-T002 (LED), per M3 plan T008.
2026-10-10 spec(m8): implementation plan + task breakdown (#128) (#131)
    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
2026-10-10 feat(m8): LedStatus LEDC driver + App wiring + endstop overlay (T002, #134) (#140)
    GPIO2 LEDC ch0 1 kHz 8-bit, gamma duties from FirmwareCore, cached
    ledcWrite (SC-004 <1 ms). begin() after boot selftest (FR-009 strapping).
    App maps DeviceState -> LedBase (D2, Homing/Ready for M3-T011) and
    forwards endstop edges as the EndstopEdge overlay outside Error (FR-005/
    FR-008). 183/183 native + esp32dev build green.
    [App.cpp, App.h, LedStatus.cpp, LedStatus.h]
2026-10-10 docs(m8): LED status guide - patterns as implemented (T004, #136) (#141)
    FR-010: operator doc mirrors the implemented table exactly; break/cal
    rows marked as pending M8-T003/M3-T011. M8 stays open until B3 (endstop
    2 wiring) and T003 land.
2026-10-10 feat(m3): IMotion startContinuous + forceStop (T009, #142) (#143)
    runForward/runBackward at current speed for homing seeks (enables the
    driver first); forceStop aborts immediately and flushes the command
    queue so a queued moveTo cannot restart the motor. stop() keeps its
    ramp semantics. 183/183 native + esp32dev build green.
2026-10-10 feat(m3): LoadCell rawForceNewton pre-filter snapshot (T010, #144) (#145)
    BreakDetector input (FR-003, D6): the same 10 Hz sample the filter
    consumed, no second blocking HX711 read. forceNewton() unchanged.
    183/183 native + esp32dev build green.
2026-10-10 docs(changelog): catch-up - M2 locale completion, M3 T003-T010, M8 LED status, CAD import (#102) (#146)
2026-10-10 feat(m3): TestRunner - cycle orchestration (T011) (#148)
    * test(m3): pin DeviceEvent::RuntimeFault transitions (T011 RED, #147)
    4 states x 6 events table extension: RuntimeFault(code) from Idle ->
    Error with the code; no-op in Booting/SelfTest/Error and with code 0.
    Backs the 0x05xx homing fault path (FR-007) TestRunner needs.
    * feat(m3): DeviceEvent::RuntimeFault - non-power runtime fault path (T011 GREEN, #147)
    Idle + code != 0 -> Error with the code, like PowerLow. TestRunner
    (T011) uses it to land 0x05xx homing faults in the DeviceModel through
    the normal event path (plan D1); code stays free of event semantics.
    * feat(m3): TestRunner - cycle orchestration over IMotion/ILoadCell/Ends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
    [App.cpp, App.h, Diagnostics.h, TestRunner.cpp, TestRunner.h, main.cpp, test_device_model.cpp]
2026-10-10 fix(test): 64 KB SampleBuffers off test frames + CI small-stack smoke (#137) (#149)
    Root cause reproduced locally: ulimit -s 128 crashed the native binary
    in the stack-probe routine (SEGV; on tighter layouts the canary fires
    in drain, the last frame before the guard - both #137 signatures).
    Every SampleBuffer local in test_sample_data.cpp is a 64 KB stack
    allocation; test_csv_tail_chunk_and_empty even had two (128 KB frame).
    Fix: one static shared buffer via sharedBuffer() (cleared per test,
    single-threaded Unity runner), static chunk arrays in the resume test.
    Proven: 185/185 green AND the binary passes under ulimit -s 128.
    CI: small-stack smoke (ulimit -s 1024 on the built binary) so an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
    [test_sample_data.cpp]
2026-10-10 feat(m3): test-cycle command surface + chunked CSV dump + TestConfig NVS (T012, #150) (#151)
    - Settings: loadTestConfig/saveTestConfig (6 NVS keys, clampTestConfig
    as the single validation boundary); App::begin applies it.
    - Commands (+TestRunner&): home/home top/test with D11 exclusivity and
    dumpInProgress guards; stop routes to the runner first (abort) with
    plain-move decel fallback; testspeed/testarm/testdrop (>0 check,
    clamped-effective reply, NVS persist, locked in fault state so the
    homing Fault latch cannot be reset behind the Error gate); data [n]
    chunked CSV dump (128 B/tick, availableForWrite-gated, documented
    stop rule incl. the empty-buffer END-only chunk); testdata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
    [App.cpp, App.h, Commands.cpp, Commands.h, Settings.cpp, Settings.h, TestRunner.h, Text.h]
2026-10-10 feat(m3): ENDSTOP1/ENDSTOP2 boot selftest rows (T013) (#153)
    * test(m3)+core: pin check vocabulary, add CheckId::Endstop1/2 (T013 RED->GREEN, #152)
    * feat(m3): ENDSTOP1/ENDSTOP2 boot selftest rows, WARN-only 0x0504 (T013, #152)
    kMaxChecks 5 -> 7; checkEndstop() reads the begin() snapshot (COM+NC:
    HIGH = pressed or broken wire -> WARN 0x0504, LOW = OK; never FAIL,
    spec A2 - parked carriage is operator judgment, the homing
    instant-trigger rule is the real guard). runBootSelfTest gains the
    Endstops& parameter; App passes it. WebUi untouched: #115 already
    sizes statuses[] from kMaxChecks and the reserve note anticipated 7
    checks (verified: WebUi.cpp:38,100-104). Bench overall-verification
    land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
    [App.cpp, Diagnostics.h, ErrorCode.h, test_error_code.cpp]
2026-10-10 feat(m8): Break + CalApplied LED overlays, Homing/Running base (T003, #135) (#154)
    - App: cycle refinement under a healthy device - Pulling/Tail -> Running
    base, (in-cycle or standalone) homing -> Homing base (FR-007: the LED
    module stays stateless, App owns the mapping).
    - Break overlay: one-shot latch on the Pulling->Tail edge WITH
    breakDetected() (buffer-full Tail does not flash); consumed by the
    LED block the same iteration (FR-005 window: Running).
    - CalApplied: read-and-clear flag set on cal_apply success in Commands,
    emitted only in Device Idle (FR-005); Error suppresses and drains
    both latches (FR-008).
    - Latest-wins ordering Break > CalApplied > EndstopEdge per FR-005.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
    [App.cpp, App.h, Commands.cpp, Commands.h]
2026-10-10 docs(m8): led-status.md - Break/CalApplied rows are live (M8-T003, #135) (#155)
2026-10-10 fix(m2/m3): endstop faults present correctly + no double 0x in Error reply (#159)
    Bench-found (T014 session, live Error-state capture):
    1. msgForFault() did not know 0x0501-0x0504 -> an endstop fault showed
    'Unknown fault.' Four mapping rows added (EN+DE), RED-first pin in
    test_msg_for_fault_maps_every_error_code.
    2. The Error-state reply printed 'code 0x0x0501' - FaultStatePrefix
    already ends in '0x' and the snprintf added a second. Only the
    padded digits are appended now (#97 grammar: code 0x0501).
    [Commands.cpp, Text.h, test_text_tables.cpp]
2026-10-10 fix(motion): invert DIR polarity - steps+ is physically UP (#160) (#161)
    * fix(m2/m3): endstop faults present correctly + no double 0x in Error reply
    * fix(motion): invert DIR polarity - steps+ is physically UP (#160)
    Bench-verified inversion: move +5mm drove t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
2026-10-10 fix(motion): dirHighCountsUp=false - the actual polarity flag (#160) (#162)
    Round 1 passed true to what I read as an 'invert' flag; this version
    names it dirHighCountsUp with default true -> no-op, proven on the
    bench (+5mm still moved the gantry down). false is the real flip
    (FastAccelStepper.cpp:57 drives the DIR level from it).
2026-10-10 feat(m3): homeseek + hometimeout commands (closes the #157 operator gap) (#163)
    The bench showed the spec defaults (seek follows testSpeed 12 mm/min,
    timeout 30 s) cover only ~6 mm of seek travel - homing from anywhere
    mid-travel faults 0x0501, and no knob was reachable from serial.
    Two persisted commands, gated like the other config changes (locked
    in fault state, rejected while a run is active - shared
    testConfigChangeAllowed gate extracted):
    - homeseek <mm/min>: explicit seek speed (0 = follow the test speed,
    reply says so via HomeSeekFollows)
    - hometimeout <s>: clamp [1, 300] s; e.g. hometimeout 180 at seek 12
    covers 36 cm of quiet homing travel
    SecondsSuffix joins the locale-invar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
2026-10-10 feat(m3): ends bench telemetry - endstop levels + homing phase live (#164)
    The T014 homing diagnosis flew blind on the one bit that mattered:
    the debounced endstop level during the seek (no serial surface; boot
    check is raw-only, the LED needs eyes on the machine). `ends` prints
    E1/E2 debounced levels, homing phase name, fault code, cycle state -
    FR-007 CHECK-grammar class (raw English, machine-facing, no Msg row).
2026-10-10 fix(m3): re-issue continuous move lost to same-tick forceStop race (#165) (#166)
    Instrumented bench run (ends_trace2.log): SeekDown trigger fires,
    FinalSeek entered, forceStop freezes the counter - and the back-off
    runForward() issued in the SAME loop tick never moves the motor
    (pending abort not yet processed; 50 ms later the engine accepts).
    The equality guard in driveHomingMotion then never re-issues.
    Reconciler in tick(): commandedDir_ != 0 && !isRunning() -> re-issue
    at the recorded intent. Every forceStop site zeroes commandedDir_, so
    that state is only the race. Also covers beginPull's latent identical
    race after the Done transition.
    [TestRunner.cpp]
2026-10-10 docs(m7): tear workflow in the web UI - US3, FR-005..008, SC-003 (#167) (#168)
    Owner request from the 2026-10-11 bench session: the complete tear
    test runnable from a phone browser - home, sample prompt, test,
    run summary, force-displacement curve, CSV download. The M3 command
    surface (home/test/data/testdata) is bench-proven (#156), so this
    lands as UI-layer FRs on the existing command policy.
2026-10-10 docs(m7): US2 visual language locked - mono + single red danger accent (#167) (#169)
    Owner decision 2026-10-11 via the #167 taste probe (rule N8): strict
    zero-colour rejected; exactly one accent, red, reserved for
    Stop/danger states. Favicon included in the no-second-hue rule.
2026-10-11 feat(m7): web UI redesign - mono single-accent + tear workflow (US3, #167) (#172)
    * feat(m7): /api/data CSV endpoint + cycle/run block in /api/status (FR-006..008)
    - /api/data streams the sample buffer through formatCsvChunk (the exact
    M3 `data` grammar) in 512 B chunks; exclusivity mirrors the command
    policy (active run -> DumpBlockedRunning, serial dump -> DumpBusy)
    - /api/status gains homed, testState (pinned TestCycleModel::name) and
    run{samples,peakN,peakIndex,break,breakMm,truncated} for FR-008
    - Content-Disposition attachment serves FR-007 (tensile-run.csv)
    * feat(m7): web UI redesign - mono single-accent + tear workflow US3 (#167)
    - US2/#169 visual language: monochrome greys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
    [TestRunner.cpp, TestRunner.h, UiHtml.h, WebUi.cpp, WebUi.h, main.cpp, test_ui_html.cpp]
2026-10-11 feat(m6): 0x06xx API error block (#177) (#185)
    * test(m6): RED - 0x06xx API error block pins (#177)
    * feat(m6): 0x06xx API error block - codes + names (#177)
    [ErrorCode.h, test_error_code.cpp]
2026-10-11 docs: session close-out - bench host-specificity fix, serial driver learnings, calibration notes, M6 status sync (#189) (#190)
2026-10-11 feat(m6): execute() ApiError mapping + pos/status restructure (#181) (#191)
    M6-T005, plan D1/D2, spec FR-001/FR-002/FR-004:
    - execute() gains ErrorCode& out-param, set at every failure return
    (29 sites incl. helpers): 0x06xx API block per plan D8; the
    Error-state rejections surface the 0x01xx..0x05xx fault itself.
    jane: lossy mappings (plan risk note, split on consumer need):
    HX711-not-ready family -> NotCalibrated, cal sequence -> StateConflict.
    - D2 layering: Commands no longer writes to Serial. printPosition()
    replaced by positionData() + static positionText() (byte-identical
    text); SerialCli renders the pos block, App renders the periodic
    status line (T006 turns both into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
    [App.cpp, Commands.cpp, Commands.h, SerialCli.cpp, WebUi.cpp]
2026-10-11 feat(m6): runner events as JSON lines (#192) (#194)
    SC-001 gap: App::reportRunnerEvents printed prose (homing datum set,
    home-top reached, test summary/limit/aborted) - the fifth emitter
    group, missed by the plan's four-emitter audit.
    - RED-first formatApiRunnerEvent (ApiRunnerEvent kind enum +
    ApiRunnerData struct): {"event":"runner","data":{"kind":...},
    "state":{...}} - 6 kinds, exact-string host tests incl. truncation
    (225/225 native).
    - App wiring: each outcome emits one event line with a state snapshot
    at emission time.
    - 8 orphaned Msg rows removed (locale gate clean, 74 ids); the kind
    spellings are the machine contract now. TestAbortedNote stays (stop
    command reply).
    - Bo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
    [App.cpp, Text.h, test_api_response.cpp]
2026-10-11 feat: machine travel cap 30 mm/min everywhere; default travel 30, tests stay 12 (#195)
    Operator decision (bench, 2026-10-11): 30 mm/min is the machine's max
    travel speed - the gantry rattles above it, 60 is mechanically unusable.
    The 30/12 split: travel (move/jog/feed default) = 30, test pull speed
    default = 12 (unchanged, TestConfig default).
    - RED-first clamp tests: feed/testsPeed/homeseek caps 60 -> 30
    (test_gear_math, test_config) - seen failing, then green: 225/225
    - MAX_MOVE_MM_PER_MIN 60 -> 30 (FirmwareCore, with the bench citation)
    - clampTestConfig: testSpeed [0.5, 30], homingSeek max 30
    - Motion::setOutputRpm now clamps to feedMmPerMinToRpm(MAX_MOVE): the
    rpm command can no lo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
    [UiHtml.h, test_config.cpp, test_gear_math.cpp]
2026-10-11 fix(#158): manual move endstop guard + motion exclusivity (#196)
    Option 1 of the issue, extended to full exclusivity (spec owner
    decision recorded on #158; RC v1.0.0.0-rc.0 gate):
    - FR-009: while a plain move (move/turn/jog) is in flight, a debounced
    endstop LEVEL in the travel direction force-stops it (the manual
    analogue of the FR-001 seeks / FR-002 limit stop). Level-triggered,
    direction-gated: a carriage resting on the datum switch can clear
    upward but never grind downward through endstop1.
    - Pure verdict manualMoveBlockedByEndstop in FirmwareCore, pinned by 6
    host tests (RED-first; mutant check: inverted direction table ->
    4 failures seen, restored).
    - Motion::moveDirection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
    [App.cpp, Commands.cpp, Commands.h, IMotion.h, test_main.cpp, test_manual_move_guard.cpp]
2026-10-11 docs: sync milestone/spec statuses after M6 close (#197)
    M6 complete (#175/#184 closed, milestone closed); M0/M2 done since
    2026-08; M7 done 2026-10-10; M3 implemented (close-out #156); M8 code
    done (SC-001/002 operator passes pending); M1 remainder is #27/#30.
    Also: the M1 power-divider hardware task (#27) is the only hardware
    blocker left on the RC v1.0.0.0-rc.0 path (feeds #30 TC-003c).
2026-10-11 fix(#95): web stale/offline indication, poll backoff, reboot notice (#198)
    - Poll: fixed 100 ms setInterval -> self-rescheduling timeout with a
    failure ladder [100, 250, 500, 1000] ms, reset on success. While
    unreachable the request rate drops to <= 1 req/s (the WebServer
    serves one client at a time - 10 req/s during degradation was the
    worst load pattern).
    - Stale state: after 1 s without contact body.stale dims the pill
    values (numeric text unchanged) and shows 'Kein Kontakt seit N s'
    (age updates each failed poll); clears automatically on recovery.
    - /api/status gains uptimeMs (monotonic boot clock): a decreasing
    value announces 'device rebooted - check position and driver s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
    [UiHtml.h, WebUi.cpp, test_ui_html.cpp]
2026-10-11 fix(#95): bound the status fetch - dead sockets after a silent reboot (#199)
    Bench-found while verifying the reboot-announce criterion: an ESP
    reboot kills established TCP connections silently (no FIN/RST - the
    stack is just gone); fetch() has no default timeout, so the poll hung
    on the dead socket FOREVER - the page never entered the stale/backoff
    path and never came back without a manual reload.
    AbortSignal.timeout(2000) on /api/status: an aborted fetch lands in
    the existing catch path (backoff + stale banner), and once the device
    answers again the uptime drop announces the reboot.
    Host pin: AbortSignal.timeout present in the served asset.
    Gates: 235/235 native, build green.
    [UiHtml.h, test_ui_html.cpp]
2026-10-11 fix(#95): latch the reboot announce - poll noise must not eat it (#200)
    Bench-found during the #95 acceptance run: the message-line reboot
    announce was transient - a failed poll during AP recovery overwrote
    it (errNoStatus) and the next success cleared it, all within seconds.
    Dedicated #rebootBanner (role=alert): shown on the uptime drop,
    survives any number of poll cycles, cleared by the next operator
    action (sendCommand - including the EN/DE toggle, so it is dismissible
    without motion).
    Host pin: id=rebootBanner present (236 native tests).
    Gates: native green, build green, locale coverage OK.
    [UiHtml.h, test_ui_html.cpp]
2026-10-11 fix: selftest rows re-render on locale switch (#201)
    Vision+DOM cross-check (computervision pass, #95 bench): the check
    rows were cached by the locale-NEUTRAL checks JSON - after a lang
    switch the rows kept the old language forever (EN page showing
    'In Ordnung'/'Nicht verdrahtet') while the API is locale-neutral
    (OK/NOT_WIRED) and the overall pill updated correctly.
    Cache key now includes the locale.
    Host pins: lastSelftestChecksKey present, lastSelftestChecksJson gone.
    Gates: native green, build green.
    [UiHtml.h, test_ui_html.cpp]
2026-10-11 fix(ui): Tensile test + Run curve side by side (50/50) on desktop (#202)
    Operator request + computervision-verified before-state: the test
    card sat in a narrow auto-fit column with empty space beside it
    ('shifted' look), the run-curve plot full-width below it.
    .row2 wrapper: both cards share one grid row (2 x minmax(0,1fr)) on
    desktop; stack below 640 px with the other single-column rules.
    Force-curve plot and all other cards unchanged.
    Host pin: row2 wrapper + .row2 .plot-card override present.
    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
    [UiHtml.h, test_ui_html.cpp]
2026-10-11 feat(ui): ATLAS brand + Home/Start test/CSV in one action row (#203)
    * feat(ui): ATLAS brand + Home/Start test/CSV in one action row
    Operator request 2026-10-11:
    - h1 'JanTec Zugversuch Steuerung'/'JanTec Tensile Test Control' ->
    'JanTec ATLAS' in EN + DE (and the static markup default)
    - Home | Start test | Download CSV share one 3-column btnrow (the CSV
    link left its lone note paragraph below the run summary)
    - .btnrow gains margin-top: 14px - clear spacing to the pills/summary
    row above (was 0, buttons hugged the pills)
    - mobile unchanged: <=640px the row stacks full-width like before
    Host pins: ATLAS x2 + old titles gone; csvDownload exactly once, in
    the btnrow3, note-wrapper gon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
2026-10-11 fix(ui): action row below the run summary pills (#204)
    Operator request: Home | Start test | Download CSV move below
    Max Kraft / Bruchweg / Messwerte (they sat between the sample
    prompt and the summary).
    Order host-pinned: runSummary precedes btnrow3 in INDEX_HTML.
    Gates: 242/242 native, build green.
    [UiHtml.h, test_ui_html.cpp]
2026-10-11 docs(m4): plan.md + tasks.md, milestone + T001-T009 issues (#214)
    Plan decisions D1-D10: one runner two modes (TestRunner drives a
    pure HoldController), deadband-P rate-limited control law (0.05
    mm/tick cap = 30 mm/min machine cap), approach threshold 50% doubles
    as the lost-floor (2-tick confirm), keep-last ring with overwrite
    count, HoldConfig rides TestConfig/clampTestConfig, hold_summary
    runner event (M6 grammar), web view-only.
    Milestone M4 (#11) + issues #205-#213 created and assigned; README
    roadmap + issue table synced in the same change (sync rule).
    Spec stays Draft until T001 lands (Status flips to In progress with
    the first task PR).
2026-10-11 feat(m4): T001 HoldConfig fields + chold parser + NVS (#205) (#215)
    - TestConfig grows holdTolerancePct [1,25] d5 + holdClearanceMm
    [1,100] d20 (closed intervals - 0 is unusable, unlike the open
    arm force) through the single clampTestConfig boundary; defaults;
    non-finite -> field default
    - parseCholdCommand (pure): 'chold <N> [minutes]' - signed setpoint,
    optional duration (0 = until stop), #42/#43 strictness (word
    boundary so choltol/choldclear never match; full token
    consumption; German decimal comma in both tokens; >=3 tokens
    invalid; negative duration invalid)
    - clampHoldSetpointN: magnitude [1,4000] N, sign preserved; zero
    passes through for the caller to reject (0 N is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
2026-10-11 feat(m4): T002 HoldController pure FSM (#206) (#216)
    TC-001: Idle -> Homing -> Approach -> Holding -> Done|Limit|Lost|
    Aborted, direction-generic (tension critical path per operator,
    compression bench-deferred to SC-002):
    - approach threshold = hold floor = 50% |setpoint| (FR-004)
    - compression transit inside Approach: up to choldclear, D26 during
    transit starts the seek instead of limiting (FR-002)
    - endstops judge ONLY in the travel direction; opposite ignored
    (datum-adjacent carriages, US3)
    - jolt-free loop entry: holdStartTick emits no correction (FR-002)
    - corrections: deadband-P, rate-limited 0.05 mm/tick (D3 preview,
    TC-003 lands the full law+accounting in T003)
    - Lost: underfl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
    [test_hold_controller.cpp, test_main.cpp]
2026-10-11 feat(m4): T003 hold report + overshoot bound proof (#207) (#217)
    - HoldController::report(): mean force, max dev %, time-in-band %,
    creep travel, hold ticks - derived pure from the FSM accumulators;
    LIVE during a hold (endPosMm updates every tick, not only at
    finish - web/bench progress needs it)
    - TC-002 spring sweep: closed loop vs linear samples 5..100 N/mm at
    50 N/5% - first peak stays <= 55 N (+10% bound); the k-envelope
    (100 N/mm = setpoint*10% / rate 0.05 mm) documented in the plan
    risk table (stiffer fixtures = bench tuning territory)
    - TC-005 accounting tests: in-band run (49 ticks, exact mean
    2449/49), drifting run (mean 1585/41, in-band 10/41, creep 31
    ticks of out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
    [test_hold_controller.cpp]
2026-10-11 feat(m4): T005 TestRunner Hold mode wiring (#209) (#218)
    D1: the runner drives the pure HoldController; one actuation path,
    one buffer, one exclusivity gate.
    - startHold(setpoint, minutes): startTest-class gates; setpoint
    clamp + 0/non-finite rejection; buffer reset; homing reuse
    (standalone if no datum - its Done sets holdHomingDone_ mid-tick)
    - tickHold at the 10 Hz cadence (the controller's rate limit is per
    tick): fresh force/position/endstops in, outputs applied:
    Approach seek = continuous at testspeed (FR-002, tracked like
    driveHomingMotion); contact = forceStop + correction rpm set to
    the machine cap (each 0.05 mm rate-limited move finishes in-tick);
    corrections = relat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
    [TestRunner.cpp, TestRunner.h]
2026-10-11 fix(m3): switch-repeatability allowance in the homing trigger guards (#219)
    Bench-found during the M4 T005 hold verification (parked-on-switch
    start, position-traced): a real KW4-3Z-3 re-triggers ~0.05 mm short
    of the ideal round trip (release/re-trigger asymmetry), so the
    SeekDown instant-trigger and FinalSeek stuck-switch guards at the
    EXACT clearance make a parked start a coin flip - the model promises
    'legitimately parked carriages never fault (FR-001)'.
    Root cause layered: the host tests configure oneStepMm = 0.25 (fat,
    convenient) while the runner passes the true 2/21968 mm - the
    tolerance the model was designed around is effectively zero on the
    bench.
    Fix: kSwitchRepeatabilityMm = 0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
    [test_homing_model.cpp]
2026-10-11 feat(m4): T006 chold surface + hold_summary event; fix(#220) approach lost + choldmax (#221)
    * feat(m4): T006 chold command surface + hold_summary event (#210)
    - chold <N> [min]: exclusivity + dump gates, startHold with the
    clamped setpoint echoed back (HoldStarted + N + for-min / until-stop)
    - choltol/choldclear: applyTestConfigValue pattern (persisted, clamped,
    effective value echoed) - the T001 TestConfig fields
    - isMotionCommand gains chold (Error-state rejection, M1 FR-009)
    - hold_summary runner event: {end, ticks, meanN, maxDevPct, inBandPct,
    creepMm} via formatApiRunnerEvent (M6 grammar), emitted by App on
    the single edge into a terminal hold phase
    - help lists chold, choltol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
    [App.cpp, App.h, Commands.cpp, Settings.cpp, Settings.h, TestRunner.cpp, TestRunner.h, Text.h]
2026-10-11 fix(m4): permanent hold telemetry + glitch median on the hold input (#222)
    Bench session 2026-10-11 (sample 3, chold 20 0.5 - the hold that
    worked) validated both changes live:
    - ends regains HOP (hold phase) PERMANENTLY: it was temp-hook-only
    during T005 verification and its absence cost a full debug round
    when a 20 N run died silently. Hold state must be observable from
    the bench; T007's web surface consumes the same accessor.
    - tickHold medians the raw force over a 3-sample window (primed at
    startHold): the bench cell produced -63..-1362 N single-sample
    spikes with samples attached (stick-slip class); the median keeps
    glitches away from contact evidence / collapse detection w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
    [Commands.cpp, TestRunner.cpp, TestRunner.h]
2026-10-11 docs: reconcile docs/specs with shipped M3-M8 state + issue renumbering (#17)
    Docs-only (no program code, deployed firmware is the status quo):
    - README: rewritten from the pre-modular single-file era to the current
    reality - full command set incl. the M4 chold family, endstop/LED/power
    wiring, /api/data, M7 UI, modular layout, real status table
    - CHANGELOG: prepend the missing post-2026-10-10 entries (M3 target wiring
    + homing close-out, M6 serial JSON API, M7 web redesign, M4 hold core,
    docs/calibration.md); replace the stale Known limitations (test modes
    ARE implemented) with the actual open items
    - AGENTS.md: layout rows for Endstops/TestRunner/LedStatus/Text, 7-check
    selfte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
